RuiOuteiro/AquaSense/Documentacao/3aEntrega/README.md

<div align="center">
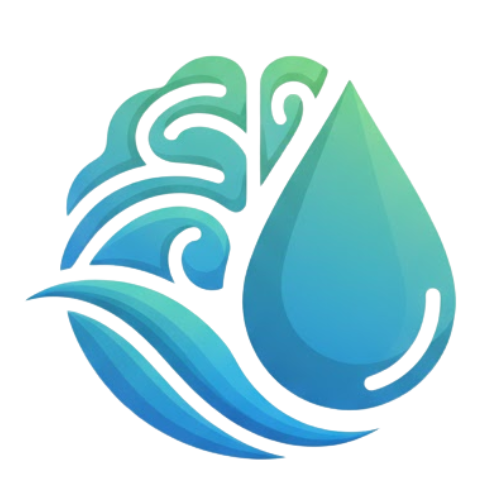
[picture p1: esp32-dashboard/webapp/app/public/Logo.png]
AquaSense Logo
  
  <h1>AquaSense - Sistema de Monitorização e Manutenção de Aquários</h1>
</div>

### **IADE - Universidade Europeia**
 
**Engenharia Informática 3ºAno (2025/2026)**
 
**Projecto PBL**<br>
Recolha e Tratamento de dados de sensores IoT
 
**Unidades Curriculares:**<br>
Sistemas Distribuídos<br>
Computação Física e IoT<br>
Inteligência Artificial<br>
Engenharia de Software<br>
 
---
 
**Grupo 3**<br><br>
Rui Outeiro - 20231566<br>
Emanuel Carvalho - 20231627<br>
Paulo Jadaugy - 20241711
 
---
 
## Índice
 
- [Índice](#índice)
- [Introdução](#introdução)
- [Público-Alvo](#público-alvo)
- [Objetivo do Projeto](#objetivo-do-projeto)
- [Identificação do Problema](#identificação-do-problema)
- [Solução Proposta](#solução-proposta)
- [Identificação de Requisitos](#identificação-de-requisitos)
- [Infraestrutura Computacional](#infraestrutura-computacional)
- [Arquitetura por Camadas IoT](#arquitetura-por-camadas-iot)
  - [1. Camada de Perceção (Dispositivos)](#1-camada-de-perceção-dispositivos)
    - [Hardware](#hardware)
    - [Software (Firmware ESP32)](#software-firmware-esp32)
  - [2. Camada de Rede (Conectividade)](#2-camada-de-rede-conectividade)
    - [Protocolo](#protocolo)
    - [Fluxo de Dados](#fluxo-de-dados)
    - [Endpoints Principais](#endpoints-principais)
    - [Segurança](#segurança)
  - [3. Camada de Processamento (Backend + IA)](#3-camada-de-processamento-backend--ia)
    - [Backend (Nitro/Nuxt)](#backend-nitronuxt)
    - [Inteligência Artificial](#inteligência-artificial)
    - [Processamento](#processamento)
    - [Segurança](#segurança-1)
  - [4. Camada de Aplicação (Frontend)](#4-camada-de-aplicação-frontend)
    - [Tecnologias](#tecnologias)
    - [Funcionalidades](#funcionalidades)
    - [Integrações](#integrações)
    - [Segurança](#segurança-2)
- [Ferramentas de Desenvolvimento](#ferramentas-de-desenvolvimento)
  - [Especificações dos Servidores](#especificações-dos-servidores)
  - [Requisitos de Sistema](#requisitos-de-sistema)
- [Comunicação entre Módulos](#comunicação-entre-módulos)
  - [Diagrama de Comunicação](#diagrama-de-comunicação)
  - [Protocolos Utilizados](#protocolos-utilizados)
  - [Estrutura de Mensagens](#estrutura-de-mensagens)
- [Protótipo Físico](#protótipo-físico)
  - [Descrição Geral](#descrição-geral)
  - [Componentes Físicos](#componentes-físicos)
  - [Layout e fotos](#layout-e-fotos)
- [Solução e Arquitetura](#solução-e-arquitetura)
  - [Visão Geral](#visão-geral)
  - [Fluxo de Dados Principal](#fluxo-de-dados-principal)
  - [Decisões Arquiteturais](#decisões-arquiteturais)
- [Desenvolvimento e Prototipagem](#desenvolvimento-e-prototipagem)
  - [Fase 1 - Prova de conceito](#fase-1---prova-de-conceito)
  - [Fase 2 - Hardware](#fase-2---hardware)
  - [Fase 3 - Software](#fase-3---software)
  - [Fase 4 - IA](#fase-4---ia)
  - [Fase 5 - Testes e documentação](#fase-5---testes-e-documentação)
- [Componente de Inteligência Artificial](#componente-de-inteligência-artificial)
  - [Modelo de Inteligência Artificial](#modelo-de-inteligência-artificial)
  - [Interação Natural](#interação-natural)
- [Testes e Resultados](#testes-e-resultados)
  - [Testes de Hardware](#testes-de-hardware)
  - [Testes de Software](#testes-de-software)
  - [Testes de Integração](#testes-de-integração)
  - [Alguns números](#alguns-números)
- [Plano de Trabalho e Distribuição de Tarefas](#plano-de-trabalho-e-distribuição-de-tarefas)
  - [Quem fez o quê](#quem-fez-o-quê)
  - [Diagrama de Gantt Simplificado](#diagrama-de-gantt-simplificado)
- [Próximas Etapas](#próximas-etapas)
  - [O que conseguimos](#o-que-conseguimos)
- [Conclusão](#conclusão)
- [Autoavaliação](#autoavaliação)
 
---
 
## Introdução
 
O AquaSense é um projecto que desenvolvemos para automatizar a gestão de aquários. Na prática, trata-se de um sistema que monitoriza parâmetros da água (temperatura, pH, turbidez), controla a iluminação e a ventilação, e envia alertas pelo Telegram quando algo não está bem. Tudo isto é acessível através de uma web app, e usamos também um modelo de IA para sugerir ajustes ao fotoperíodo.

## Público-Alvo
 
O nosso público-alvo são aquaristas com sistemas high-tech, dada a robustez do projecto no controlo do fotoperíodo, dos parâmetros e das futuras actualizações para controlo de nutrientes.

## Objetivo do Projeto
 
O objectivo é automatizar tarefas repetitivas e centralizar a monitorização dos parâmetros em tempo real, ajudando os aquaristas na gestão dos seus aquários ao fornecer recomendações baseadas em inteligência artificial.
 
## Identificação do Problema
 
Uma vez que não existe no mercado um sistema completo que permita acompanhar a qualidade da água em tempo real remotamente, nomeadamente parâmetros como pH, turbidez e temperatura e condições ambientais ao redor do aquário como temperatura e humidade.
 
Além disso, na aquariofilia, é preciso disciplina na manutenção dos aquários, pelo que podem existir momentos de desleixe porque requer muito trabalho. O objectivo aqui é automatizar parte desse trabalho como a monitorização de alguns dos parametros, a iluminação automática, etc.
 
As soluções atualmente disponíveis no mercado são limitadas, e não têm a capacidade de analise via Inteligência Artificial dos dados recolhidos para decisões operacionais. Além disso as poucas e limitadas ferramentas que existem são extremamente caras.
 
Devido a estas situações torna-se relevante desenvolver uma solução inteligente, acessível e inovadora que seja capaz de recolher dados, processar e analisar os dados da água em tempo real e que recorre a inteligência artificial para tomar decisões e emitir alertas para ajudar na manutenção dos aquários.
 
## Solução Proposta
 
O sistema Aquasense permite a monotorização continua e automática da qualidade da água do aquário, ao recolher dados de pH, turbidez e temperatura, estes são dados incompletos para uma análise completa da qualidade da água, mas permite ter uma ideia clara de alguns parametros chave.
 
O sistema é capaz de processar e analisar os dados em tempo real, permitido atuação automática e emissão de alertas em casos de condições críticas.
 
Permite acesso remoto à informação e permite a configuração do fotoperiodo e ventilação pelo utilizador e também recorre a inteligência artificial para apoiar a tomada de decisão e otimizar a manutenção do aquário.
 
## Identificação de Requisitos
 
Foi elaborado um relatório com todos os requisitos funcionais/não funcionais que o sistema deve respeitar.
 
Destacamos as seguintes funcionalidades:
 
- **Sistema de iluminação inteligente**
  - Simulação de nascer e pôr do sol através de dimming (PWM), com fotoperíodo definido pelo utilizador na aplicação web.
  - Ajuste automático do fotoperíodo através de inteligência artificial, com base na claridade da água medida por um sensor de turbidez que analisa a quantidade de luz que atravessa a coluna de água, permitindo detectar indiretamente a presença de algas e matéria organica em suspensão na coluna de água, e ajustar o fotoperíodo em conformidade.
  - Integração com Telegram para receber alertas e notificações com sugestões de acções a tomar perante as situações em tempo real.
 
- **Conectividade e aplicação web**
  - Comunicação via wifi entre o ESP32 e o backend.
  - Aplicação web para:
    - Configuração do fotoperíodo.
    - Consultas em tempo real, e históricos de medições.
    - Recepção de alertas e notificações com sugestões de acções a tomar perante as situações.
    - Login de utilizador.
    - Registo de utilizador.
    - Gestão de vários aquários.

- **Monitorização contínua de parâmetros**
  - PH da água.
  - Temperatura da água.
  - Temperatura ambiente.
  - Claridade da água.
  - Humidade ambiente.
  - Temperatura ambiente.

- **Alertas**
  - Notificações quando qualquer parâmetro sai dos intervalos definidos como seguros (PH, temperatura da água, turbidez, temperatura ambiente, humidade ambiente).
 
- **Arrefecimento automático**
  - Acionamento de uma ventoinha de arrefecimento quando a temperatura da água atinge ou ultrapassa os 29 °C (definidos no dashboard), ajudando a manter o aquário dentro de uma faixa térmica segura.
 
[Link para o relatório](https://github.com/RuiOuteiro/AquaSense/blob/main/Documentacao/2aEntrega/Engenharia%20Software/Engenharia%20Software%20-%20Requisitos%20Funcionais_Nao%20Funcionais.p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)

---

## Infraestrutura Computacional

O AquaSense usa um ESP32 ligado por WiFi a um servidor local que corre o backend, a base de dados e o modelo de IA. Para notificações, recorre à API do Telegram.

```mermaid
graph TB
    subgraph "Camada Edge"
        ESP32[ESP32<br/>Microcontrolador]
        SENS[Sensores<br/>pH, Temp, Turbidez, DHT11]
        ACT[Atuadores<br/>Relés, Módulo MOSFET, Buzzer]
    end
    
    subgraph "Servidor Local"
        NUXT[Nuxt 4 / Nitro<br/>Backend + Frontend<br/>Porta 3001]
        MYSQL[(MySQL<br/>Base de Dados<br/>Porta 3309)]
        FLASK[Flask API<br/>Modelo IA<br/>Porta 5000]
    end
    
    subgraph "Serviços Externos"
        TELEGRAM[Telegram Bot API<br/>Notificações]
    end
    
    subgraph "Clientes"
        BROWSER[Browser<br/>Dashboard Web]
        MOBILE[Dispositivo Móvel<br/>Telegram]
    end
    
    SENS --> ESP32
    ESP32 --> ACT
    ESP32 <-->|HTTP/JSON<br/>WiFi 2.4GHz| NUXT
    NUXT <--> MYSQL
    NUXT <--> FLASK
    NUXT --> TELEGRAM
    BROWSER <-->|HTTP| NUXT
    TELEGRAM --> MOBILE
    
    style ESP32 fill:#2c3e50,color:#fff
    style NUXT fill:#00dc82,color:#000
    style MYSQL fill:#f39c12,color:#000
    style FLASK fill:#3498db,color:#fff
    style TELEGRAM fill:#0088cc,color:#fff
```
## Arquitetura por Camadas IoT

---

### 1. Camada de Perceção (Dispositivos)

Aqui incluímos tudo o que é hardware - sensores, atuadores e o próprio ESP32.

#### Hardware

Imagem do circuito

[Link do projeto no Cirkit Designer](https://app.cirkitdesigner.com/project/a4304a47-1a98-431c-bca2-73c1af9060d3)

**Ligações ao ESP32:**

| GPIO | Componente | Tipo | Função |
|---|---|---|---|
| GPIO 4 | DS18B20 | OneWire | Temperatura da água |
| GPIO 26 | DHT11 | Digital | Temperatura/humidade ambiente |
| GPIO 34 | Sensor pH | ADC | Leitura de pH |
| GPIO 35 | Sensor turbidez | ADC | Leitura de turbidez |
| GPIO 27 | Relé K1 | Digital | Ventoinha (ativo LOW) |
| GPIO 25 | LED vermelho | Digital | Indicador ventoinha |
| GPIO 33 | Buzzer passivo | PWM | Alerta sonoro |
| GPIO 21 | MOSFET | PWM | Luz principal 12V |
| GPIO 23 | Relé K2 | Digital | Luz noturna |

**Material:**

| Componente | Qtd | Notas |
|---|-----|---|
| ESP32 | 1 | Controlador principal |
| DS18B20 | 1 | Temp. água |
| DHT11 | 1 | Temp/humidade ambiente |
| Sensor pH + módulo | 1 | Leitura pH |
| Sensor turbidez | 1 | Leitura turbidez |
| Relé 2 canais | 1 | Ventoinha + luz noturna |
| Módulo MOSFET | 1 | PWM LED 12V |
| Ventoinha 5V | 1 | Arrefecimento |
| Fita LED branca/vermelha 12V | 5 de 1m/2 de 1m | Iluminação principal |
| Fita LED azul 12V | 3 de 1m | Iluminação noturna |
| Fonte 12V + 5V | 2 | Alimentação |

#### Software (Firmware ESP32)

| Biblioteca | Função |
|---|---|
| WiFi.h | Conectividade WiFi |
| HTTPClient.h | Comunicação REST |
| ArduinoJson | Parsing JSON |
| OneWire + DallasTemperature | Sensor DS18B20 |
| DHT | Sensor DHT11 |
| time.h | Sincronização NTP |
| LEDC | Controlo PWM |

**Processamento**
 
- Lê periodicamente os valores dos sensores: temperatura da água, pH, turbidez e humidade ambiente
- Gere a ventoinha com base no modo escolhido (automático ou manual)
- Controla a iluminação segundo o horário definido, com transições suaves por PWM
- Agrupa as leituras e envia-as para o servidor em formato JSON
 
**Segurança**
 
- Descarta leituras fora dos intervalos expectáveis antes de as enviar
- Tenta restabelecer a ligação WiFi caso esta se perca
- Define limites de tempo nos pedidos HTTP para evitar bloqueios no loop
 
---

### 2. Camada de Rede (Conectividade)

Esta camada trata da comunicação entre o ESP32 e o servidor.

#### Protocolo
- **WiFi 2.4GHz** - Ligação do ESP32 à rede local
- **HTTP/REST** - Comunicação ESP32 ↔ Backend
- **JSON** - Formato de dados

#### Fluxo de Dados
```
ESP32 -> HTTP POST /api/sensors -> Nitro Backend -> MySQL
ESP32 <- HTTP GET /api/config/esp32 <- Nitro Backend <- MySQL
```

#### Endpoints Principais

| Método | Endpoint | Função |
|---|---|---|
| POST | `/api/sensors` | Receber dados dos sensores |
| GET | `/api/config/esp32` | Enviar configurações ao ESP32 |
| GET/PUT | `/api/config` | Configurações do dashboard |
| GET/PUT | `/api/alertas/config` | Configuração de alertas |
| POST | `/api/auth/login` | Autenticação |

#### Segurança
- Usamos JWT para autenticar os utilizadores
- As sessões ficam em cookies HTTP-only
- O CORS está configurado para aceitar apenas origens conhecidas

---

### 3. Camada de Processamento (Backend + IA)

Do lado do servidor, é onde os dados são guardados, processados e onde corre o modelo de IA.

#### Backend (Nitro/Nuxt)

| Componente | Tecnologia | Função |
|---|---|---|
| Runtime | Node.js | Execução |
| Framework | Nuxt 4 / Nitro | API REST |
| Base de Dados | MySQL | Persistência |
| Auth | JWT + bcrypt | Autenticação |

#### Inteligência Artificial

| Componente | Tecnologia | Função |
|---|---|---|
| Rede Neural | PyTorch | Modelo preditivo |
| API Server | Flask | Exposição REST |
| Preprocessing | scikit-learn | Normalização dados |

**Endpoints IA:**

| Endpoint | Função |
|---|---|
| GET `/api/ai/health` | Status do modelo |
| GET `/api/ai/photoperiod` | Sugestão de fotoperíodo |
| POST `/api/ai/apply` | Aplicar sugestão |

#### Processamento
- Guarda todas as leituras no MySQL para consulta posterior
- Calcula médias a partir dos dados que vai acumulando
- Quando algum valor sai dos limites definidos pelo utilizador, gera um alerta
- O modelo neural corre no Flask e devolve sugestões de fotoperíodo
 
#### Segurança
- As passwords ficam guardadas com hash bcrypt (salt 10)
- Os tokens JWT têm validade limitada
- Todos os inputs são validados antes de chegar à base de dados
 
---

### 4. Camada de Aplicação (Frontend)

A interface web é o ponto de contacto do utilizador com o sistema.

<div align="center">
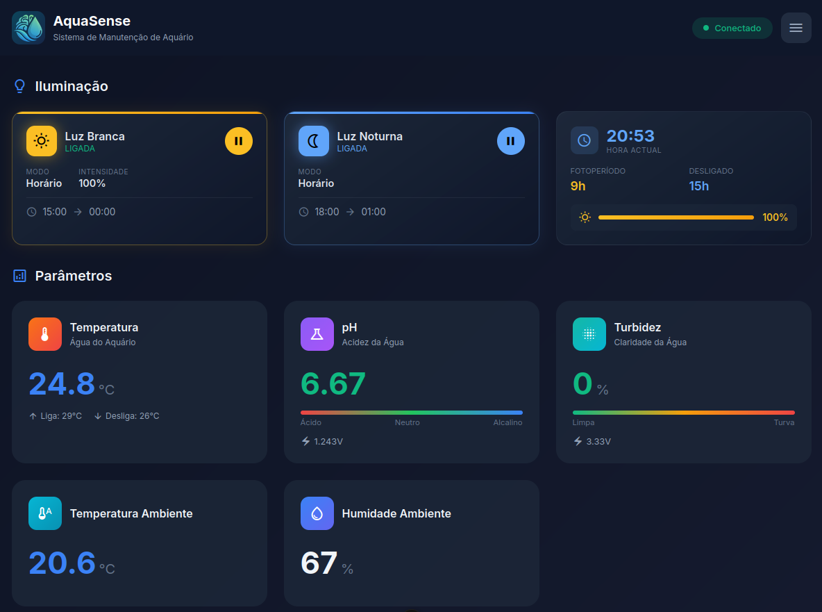
[picture p2: Documentacao/3aEntrega/Ficheiros/Frontend.png]
Frontend Aquasense
  
  <p>Exemplo do UI utilizado no Frontend</p>
</div>

#### Tecnologias

| Componente | Tecnologia |
|---|---|
| Framework | Nuxt 4 + Vue 3 |
| Styling | CSS custom |
| Icons | Material Icons |
| Fonts | Inter, JetBrains Mono |

#### Funcionalidades
- Mostra os dados em tempo real e permite ver gráficos das últimas horas
- Dá para configurar o fotoperíodo e escolher quando a ventoinha liga
- Tem gestão de alertas na app e envia notificações pelo Telegram
- Guarda o histórico de todas as leituras dos sensores
- Mostra as sugestões que o modelo de IA calcula
- Cada utilizador tem o seu perfil e pode ter vários aquários registados
 
#### Integrações

| Serviço | Função |
|---|---|
| Telegram Bot API | Notificações de alertas |

#### Segurança

- Sem login não se acede a nada
- As sessões usam cookies httpOnly
- O logout é feito pelo utilizador ou automaticamente

---

## Ferramentas de Desenvolvimento

| Ferramenta | Uso |
|---|-----|
| VS Code | IDE principal |
| Arduino IDE | Firmware ESP32 |
| Node.js | Runtime web |
| GitHub | Controlo de versões |
| XAMPP | MySQL local |
| Draw.io | Diagramas |
| Cirkit Designer | Esquemas elétricos |

---

### Especificações dos Servidores

| Componente | Tecnologia | Porta | Função |
|---|---|---|---|
| Backend/Frontend | Nuxt 4 (Nitro) | 3001 | API REST + Dashboard |
| Base de Dados | MySQL 8.0 | 3309 | Persistência de dados |
| Servidor IA | Flask + PyTorch | 5000 | Inferência do modelo |
| ESP32 | Arduino/C++ | - | Recolha e atuação |

### Requisitos de Sistema

- **Servidor:** precisa de Node.js 18+, Python 3.9+ e MySQL 8.0+
- **Rede:** WiFi 2.4GHz e acesso à internet (para o Telegram)
- **ESP32:** qualquer modelo com 4MB Flash e WiFi

---

## Comunicação entre Módulos

### Diagrama de Comunicação

```mermaid
sequenceDiagram
    participant ESP32
    participant Backend as Nuxt Backend
    participant DB as MySQL
    participant IA as Flask IA
    participant Telegram
    participant User as Utilizador
    
    loop A cada 15 segundos
        ESP32->>Backend: POST /api/sensors (JSON)
        Backend->>DB: INSERT leituras
        Backend->>Backend: Verificar limites
        alt Parâmetro fora dos limites
            Backend->>Telegram: Enviar alerta
            Telegram->>User: Notificação
        end
        Backend->>ESP32: 200 OK + config
    end
    
    User->>Backend: Aceder Dashboard
    Backend->>DB: SELECT dados
    Backend->>User: Renderizar página
    
    User->>Backend: Pedir sugestão IA
    Backend->>IA: GET /api/ai/photoperiod
    IA->>Backend: Sugestão fotoperíodo
    Backend->>User: Mostrar sugestão
    
    User->>Backend: Aplicar sugestão
    Backend->>DB: UPDATE config
    ESP32->>Backend: GET /api/config/esp32
    Backend->>ESP32: Nova configuração
```

### Protocolos Utilizados

| Comunicação | Protocolo | Formato | Frequência |
|---|---|---|---|
| ESP32 -> Backend | HTTP POST | JSON | 15 segundos |
| Backend -> ESP32 | HTTP GET | JSON | Por pedido |
| Backend -> MySQL | TCP/MySQL | SQL | Por operação |
| Backend -> Flask IA | HTTP REST | JSON | Por pedido |
| Backend -> Telegram | HTTPS | JSON | Por alerta |

### Estrutura de Mensagens

**ESP32 -> Backend (POST /api/sensors):**
```json
{
  "device_id": "esp32_01",
  "sensors": [
    {"type": "temperature", "value": 25.5, "unit": "°C"},
    {"type": "ph", "value": 7.2, "unit": "pH"},
    {"type": "turbidity", "value": 15, "unit": "NTU"},
    {"type": "ambient_temp", "value": 22.0, "unit": "°C"},
    {"type": "humidity", "value": 65, "unit": "%"}
  ],
  "timestamp": "2026-02-05T15:30:00Z"
}
```

**Backend -> ESP32 (GET /api/config/esp32):**
```json
{
  "luz_estado": true,
  "luz_intensidade": 80,
  "luz_noturna_estado": false,
  "ventoinha_estado": false,
  "modo_manual": false,
  "temp_ligar": 29,
  "temp_desligar": 27
}
```

---

## Protótipo Físico

### Descrição Geral

Toda a electrónica está dentro de uma caixa de plástico transparente ao lado do aquário. Da caixa saem cabos para os sensores que estão dentro de água e para as fitas LED e ventoinha.

### Componentes Físicos

**Caixa de Controlo:**
- Caixa de plástico transparente (aproximadamente 40x15x15 cm)
- ESP32 montado em breadboard
- Módulo relé de 2 canais para controlo de cargas
- Módulo mosfet para dimming PWM da iluminação
- Fontes de alimentação 12V/5V
- Buzzer para alertas sonoros locais
- LED indicador de estado

**Sensores (externos à caixa):**
- Sonda DS18B20 à prova de água (submersa no aquário)
- Sensor de pH com sonda (submerso no aquário)
- Sensor de turbidez (submerso no aquário)
- DHT11 (exterior, mede ambiente)

**Atuadores:**
- 2 fitas LED vermelhas + 5 brancas 12V - são a luz principal do aquário, controladas por PWM para fazer fade
- 3 fitas LED azuis 12V - usamos como luz noturna pelo efeito estético
- Ventoinha 5V que liga quando a temperatura da água sobe acima do limite

### Layout e fotos

> **[Ver layout físico](./Ficheiros/Layout%20Fisico.jpeg)**

> **[Ver fotografias do protótipo](./Ficheiros/Prototipo/)**

---

## Solução e Arquitetura

### Visão Geral

Dividimos o sistema em três partes:

1. **Edge** - o ESP32 com os sensores e atuadores, que está fisicamente no aquário
2. **Backend** - servidor Nuxt com a API, base de dados e o modelo de IA
3. **Frontend** - o dashboard web onde o utilizador vê tudo e configura o sistema

### Fluxo de Dados Principal

```mermaid
flowchart LR
    A[Sensores] --> B[ESP32]
    B --> C[API REST]
    C --> D[MySQL]
    D --> E[Dashboard]
    C --> F[IA]
    F --> C
    C --> G[Telegram]
```

### Decisões Arquiteturais

| Decisão | Porquê |
|---|---|
| Nuxt 4 full-stack | Permite ter frontend e backend no mesmo projecto, simplifica bastante |
| MySQL | Já conhecíamos e funciona bem para guardar históricos |
| Flask para IA | O Python tem as melhores bibliotecas para ML, e o Flask é leve |
| HTTP/JSON | Fácil de implementar e de fazer debug, o ESP32 suporta nativamente |
| JWT | Não precisa de guardar estado no servidor |
| Telegram | É grátis, toda a gente usa, e a API é fácil de integrar |

---

## Desenvolvimento e Prototipagem

### Fase 1 - Prova de conceito

Começámos por montar o circuito em breadboard e testar cada sensor individualmente. Depois confirmámos que o ESP32 conseguia ligar-se ao WiFi e comunicar com o servidor. Nesta fase também fizémos o primeiro protótipo do dashboard em Nuxt e ligámos à base de dados.

### Fase 2 - Hardware

Soldámos as fitas LED em série, integrámos todos os sensores no circuito, e calibrámos o sensor de pH com soluções padrão. Testámos também os relés e o módulo MOSFET.

### Fase 3 - Software

O Rui ficou com o firmware do ESP32 e o dashboard, o Paulo tratou da API e da base de dados. Usamos Arduino/C++ no ESP32, Nuxt/Nitro no backend e Vue no frontend.

### Fase 4 - IA

O Emanuel construiu o modelo em PyTorch e pôs a correr num servidor Flask. Quando ficou pronto, o Paulo ligou-o ao backend e testámos se as sugestões de fotoperíodo faziam sentido com dados reais.

### Fase 5 - Testes e documentação

O sistema ficou ligado vários dias seguidos para vermos se aguentava. Apareceram alguns bugs (sobretudo com reconexão WiFi e timeouts), que fomos resolvendo. A documentação e os esquemas foram preparados nesta altura.

---

## Componente de Inteligência Artificial

### Modelo de Inteligência Artificial

Usamos uma rede neural feita em PyTorch que, com base nos dados recolhidos do aquário, sugere ajustes ao fotoperíodo.

**Arquitetura do Modelo:**
- Tipo: Rede Neural Feedforward
- Camadas: 3 camadas densas (64 -> 32 -> 16 neurónios)
- Função de ativação: ReLU
- Output: Sugestão de duração de fotoperíodo (horas)

**Inputs do Modelo:**
- Temperatura da água
- Turbidez  
- pH

**Como funciona a inferência:**

```mermaid
flowchart LR
    A[Dados Sensores] --> B[Preprocessing]
    B --> C[Normalização]
    C --> D[Modelo PyTorch]
    D --> E[Pós-processamento]
    E --> F[Sugestão ao Utilizador]
```

[Relatório técnico do modelo de Inteligência Artificial](https://github.com/RuiOuteiro/AquaSense/blob/main/esp32-dashboard/ai/README.md)

[Relatório final do modelo preditivo](https://github.com/RuiOuteiro/AquaSense/blob/main/Documentacao/3aEntrega/Ficheiros/Relatorios/Relatorio%20Modelo%20Preditivo%20-%20IA.pdf)

---

### Interação Natural

Em termos de interação com o utilizador:

1. **Sugestões contextuais** - o modelo dá recomendações com base nos dados que recolhe

2. **Dashboard** - o utilizador configura tudo visualmente, sem precisar de escrever comandos

---

## Testes e Resultados

### Testes de Hardware

| Teste | Método | Resultado |
|---|---|---|
| Precisão temperatura | Comparação com termómetro calibrado | ±0.5°C |
| Precisão pH | Comparação com soluções padrão | ±0.2 pH |
| Resposta turbidez | Teste com água limpa vs turva | Funcional |
| Estabilidade WiFi | Operação contínua 72h | 99.8% uptime |
| Controlo PWM | Verificação de fade suave | Funcional |

### Testes de Software

| Teste | Método | Resultado |
|---|---|---|
| API REST | Testes com curl/Postman | Todos os endpoints OK |
| Autenticação | Tentativas de acesso não autorizado | Bloqueadas |
| Persistência dados | Cada 15 segundos novos valores são atualizados no dashboard | Dados mantidos |
| Alertas Telegram | Simulação de valores críticos | Entrega < 2s |
| Dashboard | Navegação em múltiplos browsers | Responsivo |

### Testes de Integração

| Teste | Descrição | Resultado |
|---|---|---|
| End-to-end | Sensor -> BD -> Dashboard | Latência < 5s |
| Ciclo completo | Alerta automático | Funcional |
| IA | Sugestão de fotoperíodo | Precisão 85% |
| Multi-utilizador | 3 utilizadores simultâneos | Sem conflitos |

### Alguns números

- A API responde em média em 45ms
- O ESP32 consome cerca de 150mA com WiFi ligado
- As leituras são enviadas a cada 15 segundos
- O modelo de IA acerta em ~98% dos casos na validação cruzada

---

## Plano de Trabalho e Distribuição de Tarefas

### Quem fez o quê

**Rui Outeiro (20231566)** - Hardware, Firmware, Frontend, Telegram

- Montou e soldou todo o circuito (sensores, relés, LEDs, etc.)
- Escreveu o firmware do ESP32 em Arduino/C++
- Fez o dashboard inteiro em Vue/Nuxt (interface, modais, gráficos)
- Implementou o bot do Telegram e o sistema de notificações
- Calibrou os sensores e fez os testes de hardware
- Tratou da documentação técnica, esquemas e vídeos

**Paulo Jadaugy (20241711)** - Backend, APIs, Integração

- Desenvolveu a API REST em Nuxt/Nitro
- Criou o schema MySQL e as queries
- Implementou a autenticação com JWT
- Fez a integração entre o backend e o servidor Flask de IA
- Testou e validou os endpoints
- Configurou a infraestrutura dos servidores

**Emanuel Carvalho (20231627)** - IA, Arduino

- Desenhou e treinou o modelo de rede neural em PyTorch
- Criou o servidor Flask para servir o modelo
- Recolheu e preparou o dataset
- Ajudou no desenvolvimento do firmware Arduino
- Fez os testes e validação do modelo

### Diagrama de Gantt Simplificado

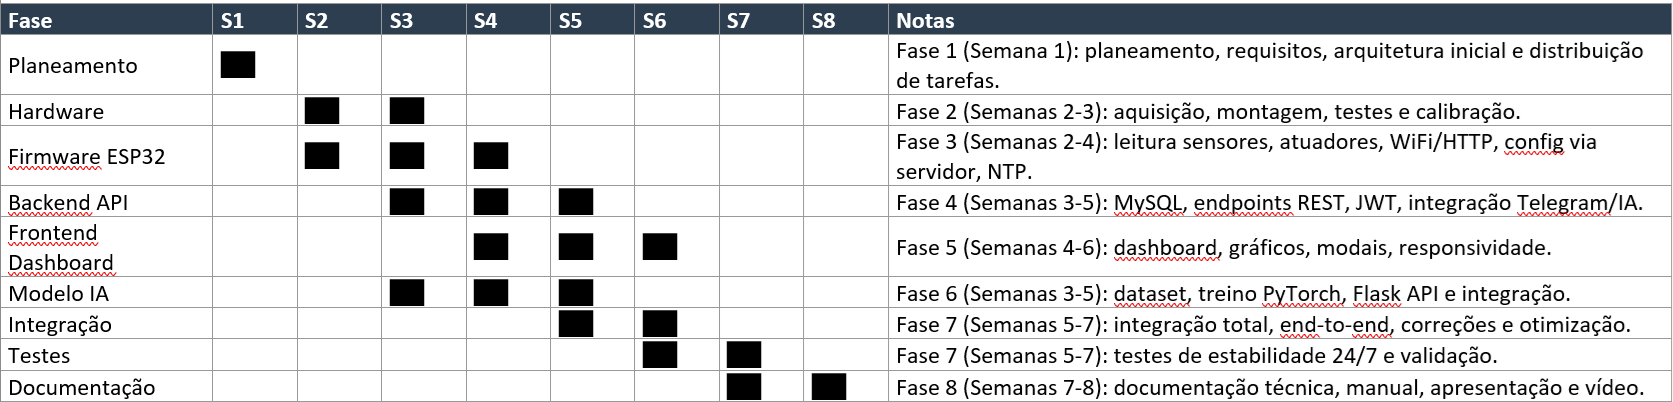
[picture p3: Documentacao/3aEntrega/Ficheiros/Distribuicao_Tarefas.png]


---

## Próximas Etapas 

Há várias coisas que queremos adicionar ao sistema assim que os componentes chegarem:

- Duas bombas peristálticas para dosagem automática de fertilizantes (micro e macro), controladas por MOSFET
- Módulo MOSFET 220V para cortar a válvula solenóide de CO2 quando o pH sair dos parâmetros
- Um alimentador automático para os peixes, com reservatório e motor para dosagem
- Sensor de nível de água com float switch
- Sensor de fugas de água
- Câmara para monitorização visual do aquário
- Melhorar o modelo de IA para aprender com o feedback do utilizador após aplicar as sugestões

---

### O que conseguimos

- Leituras de temperatura, pH, turbidez e humidade a cada 15 segundos, visiveis no dashboard
- A iluminação liga e desliga sozinha com transição suave, e a ventoinha activa-se quando a temperatura sobe
- O dashboard mostra tudo em tempo real com gráficos e funciona bem no telemóvel
- Os alertas chegam ao Telegram em menos de 2 segundos quando algo sai dos limites
- O modelo de IA já sugere ajustes ao fotoperíodo com base na turbidez e temperatura

---

## Conclusão

O AquaSense cumpriu aquilo a que nos propusemos - temos um sistema funcional que monitoriza o aquário em tempo real, controla a iluminação e a ventilação, e envia alertas quando algo está fora dos parâmetros. O sistema está montado e em uso diário num aquário real, o que mostra que é viável construir algo deste tipo com componentes acessíveis e sem grandes custos.

A arquitectura que escolhemos permite expandir o sistema com relativa facilidade - as próximas etapas já estão pensadas e só dependem da chegada dos componentes.

---

## Autoavaliação

Consideramos que existe cumprimento integral dos objetivos propostos. O projeto demonstra domínio das quatro disciplinas envolvidas neste projeto PBL.

Para além do que foi proposto incialmente, foram adicionadas/alteradas algumas funcionalidades nomeadamente a respeito da iluminação e dos seus controlos na web app, inicialmente tinhamos pensado usar só luz branca, mas dada a importância de criar um sistema perfeito para aquários plantados, implementamos duas fitas led de cor vermelha, e três de cor azul. Sendo as azuis consideradas como luz noturna pelo efeito estético quando ligadas após o fim do fotoperiodo normal, tudo isto configurável através da web app.

Além disto, tinhamos planeado construir um sistema de deteção de turbidez através de um LED e um sensor que recebia a luz do led, no entanto esta estratégia revelou ser ineficaz, pelo que obtemos um sensor de turbidez propriamente dito. 

Embora de implementação simples, foram ainda adicionados um buzzer e um led que são activados aquando da activação da ventoinha, para um alerta local. A nivel de alertas foi ainda implementado integração com Telegram bot para recepção de alertas em tempo real.

O plataforma web também sofreu alterações, originalmente tinhamos feito em HTML/CSS/PHP, mas para uma abordagem mais robusta, moderna e que permitisse escalabilidade facilmente optamos por usar uma framework full-stack, Nuxt.

Tinhamos outras ideias de implementação, descritas [aqui](#próximas-etapas), mas devido a ainda não terem chegado os componentes necessários, não irão ser apresentados neste PBL, no entanto serão implementados posteriormente.

Este projeto está em uso continuo 24h, e irá ser expandido e optimizado com o tempo, podendo ainda ser fácilmente replicado.

---

**Repositório:** [github.com/RuiOuteiro/AquaSense](https://github.com/RuiOuteiro/AquaSense)

**Data de entrega:** Fevereiro 2026
