RuiOuteiro/AquaSense/Documentacao/3aEntrega/Ficheiros/Layout Fisico.jpeg

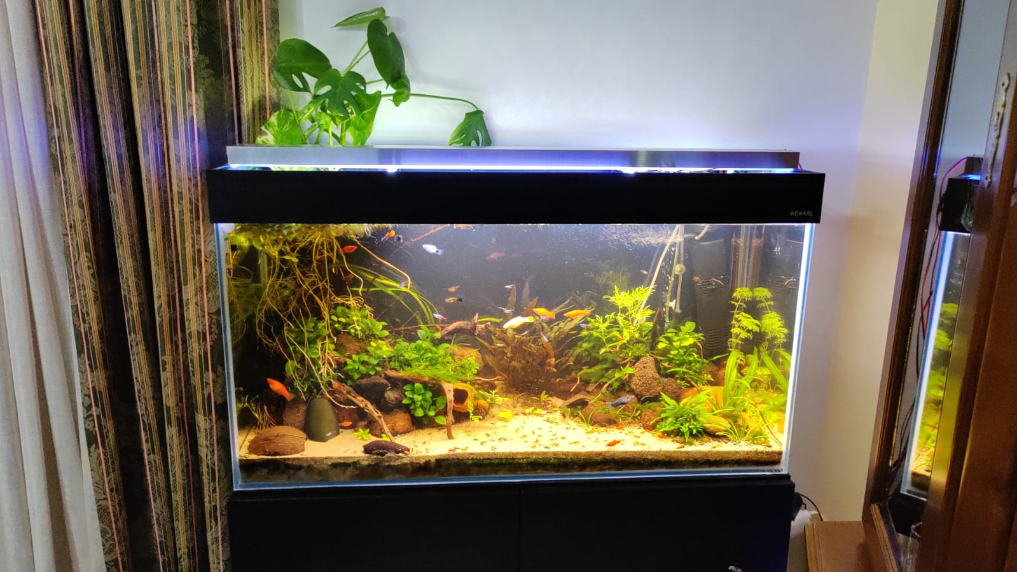
Documentacao/3aEntrega/Ficheiros/Layout Fisico.jpeg
