RuiOuteiro/AquaSense/Documentacao/3aEntrega/Ficheiros/Prototipo/imagem_001.jpeg

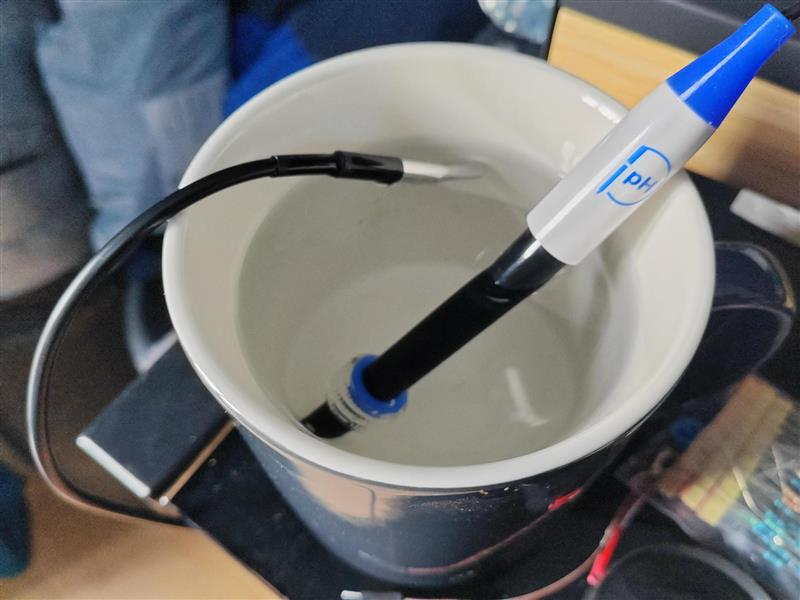
Documentacao/3aEntrega/Ficheiros/Prototipo/imagem_001.jpeg
