RuiOuteiro/AquaSense/Documentacao/3aEntrega/Ficheiros/Prototipo/imagem_002.jpeg

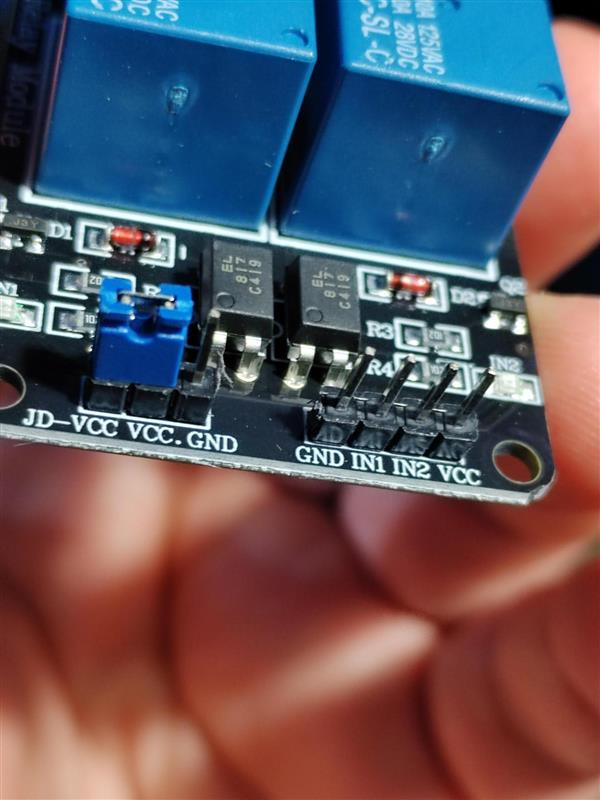
Documentacao/3aEntrega/Ficheiros/Prototipo/imagem_002.jpeg
