RuiOuteiro/AquaSense/Documentacao/3aEntrega/Ficheiros/Prototipo/imagem_003.jpeg

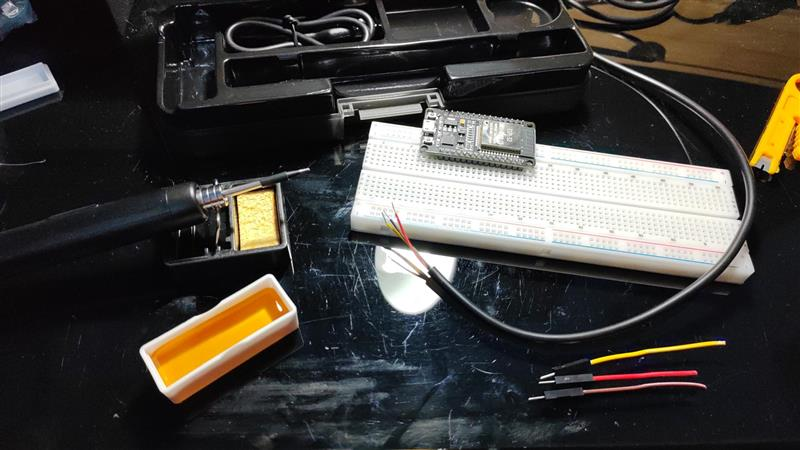
Documentacao/3aEntrega/Ficheiros/Prototipo/imagem_003.jpeg
