RuiOuteiro/AquaSense/Documentacao/3aEntrega/Ficheiros/Prototipo/imagem_004.jpeg

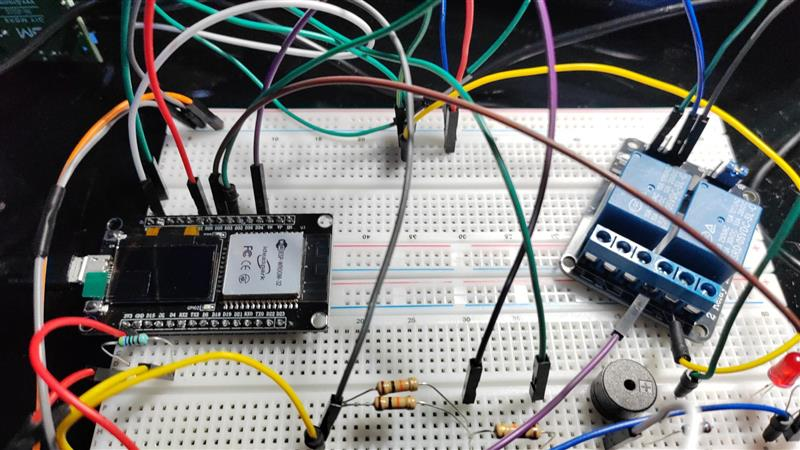
Documentacao/3aEntrega/Ficheiros/Prototipo/imagem_004.jpeg
