RuiOuteiro/AquaSense/Documentacao/3aEntrega/Ficheiros/Prototipo/imagem_005.jpeg

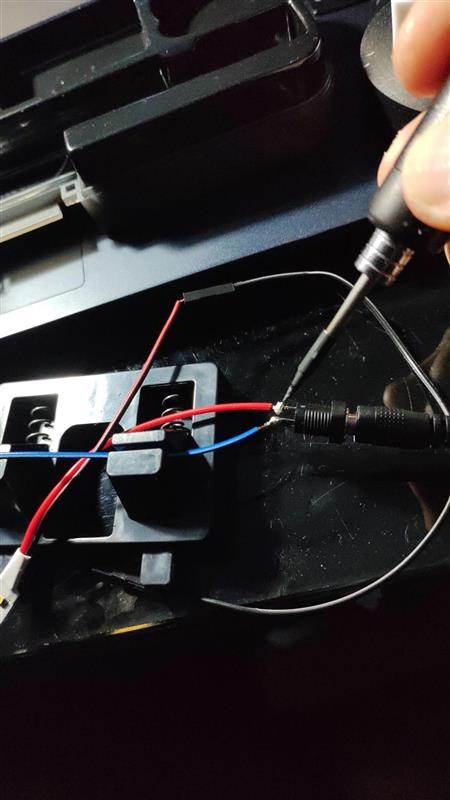
Documentacao/3aEntrega/Ficheiros/Prototipo/imagem_005.jpeg
