RuiOuteiro/AquaSense/Documentacao/3aEntrega/Ficheiros/Prototipo/imagem_006.jpeg

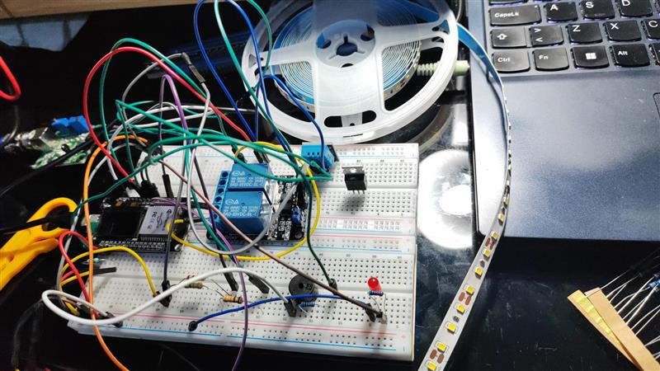
Documentacao/3aEntrega/Ficheiros/Prototipo/imagem_006.jpeg
