RuiOuteiro/AquaSense/Documentacao/3aEntrega/Ficheiros/Prototipo/imagem_007.jpeg

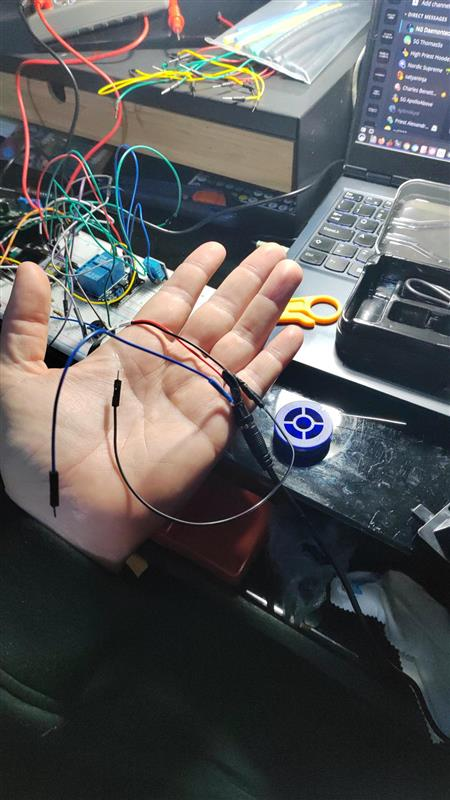
Documentacao/3aEntrega/Ficheiros/Prototipo/imagem_007.jpeg
