RuiOuteiro/AquaSense/Documentacao/3aEntrega/Ficheiros/Prototipo/imagem_008.jpeg

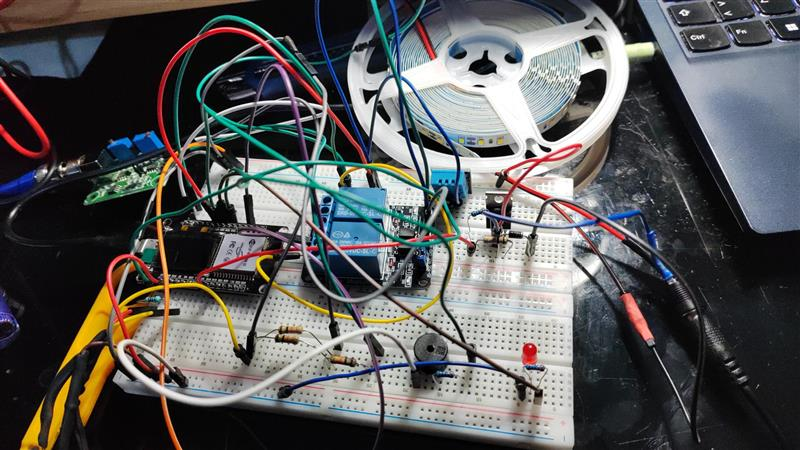
Documentacao/3aEntrega/Ficheiros/Prototipo/imagem_008.jpeg
