RuiOuteiro/AquaSense/Documentacao/3aEntrega/Ficheiros/Prototipo/imagem_009.jpeg

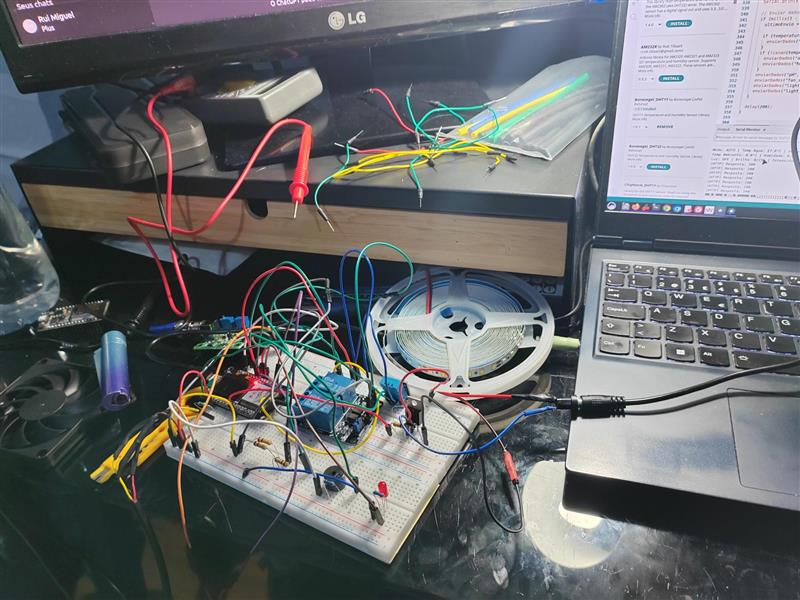
Documentacao/3aEntrega/Ficheiros/Prototipo/imagem_009.jpeg
