RuiOuteiro/AquaSense/Documentacao/3aEntrega/Ficheiros/Prototipo/imagem_010.jpeg

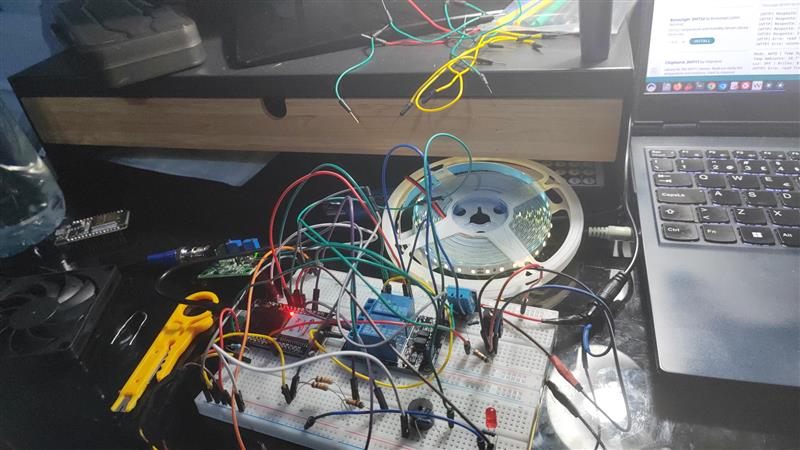
Documentacao/3aEntrega/Ficheiros/Prototipo/imagem_010.jpeg
