RuiOuteiro/AquaSense/Documentacao/3aEntrega/Ficheiros/Prototipo/imagem_011.jpeg

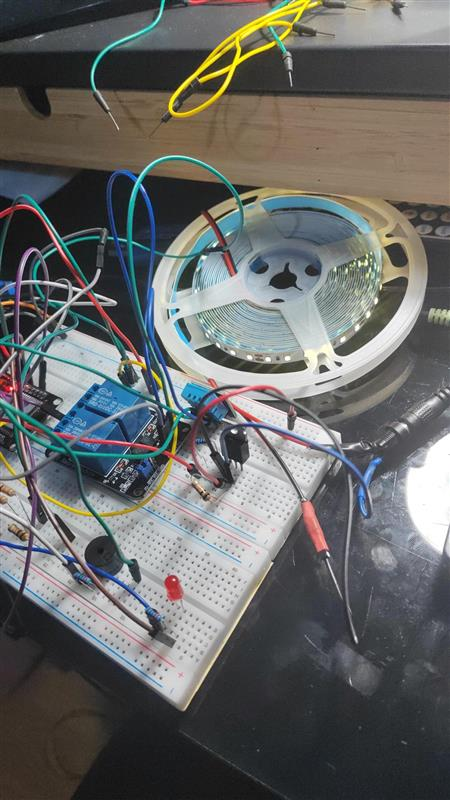
Documentacao/3aEntrega/Ficheiros/Prototipo/imagem_011.jpeg
