RuiOuteiro/AquaSense/Documentacao/3aEntrega/Ficheiros/Prototipo/imagem_012.jpeg

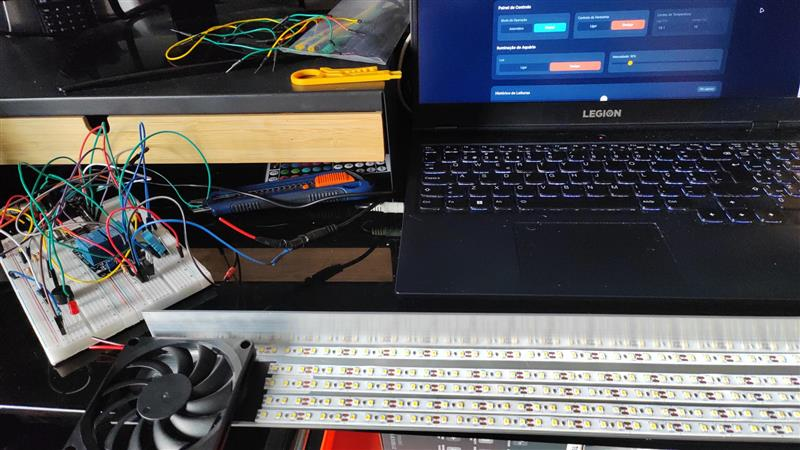
Documentacao/3aEntrega/Ficheiros/Prototipo/imagem_012.jpeg
