RuiOuteiro/AquaSense/Documentacao/3aEntrega/Ficheiros/Prototipo/imagem_013.jpeg

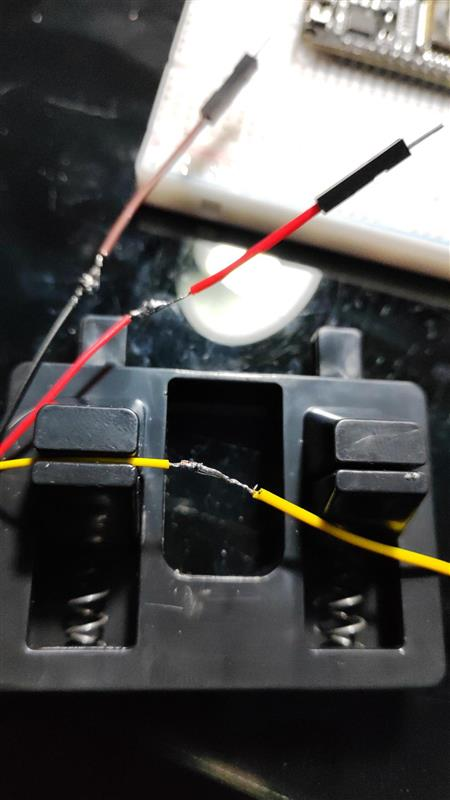
Documentacao/3aEntrega/Ficheiros/Prototipo/imagem_013.jpeg
