RuiOuteiro/AquaSense/Documentacao/3aEntrega/Ficheiros/Prototipo/imagem_014.jpeg

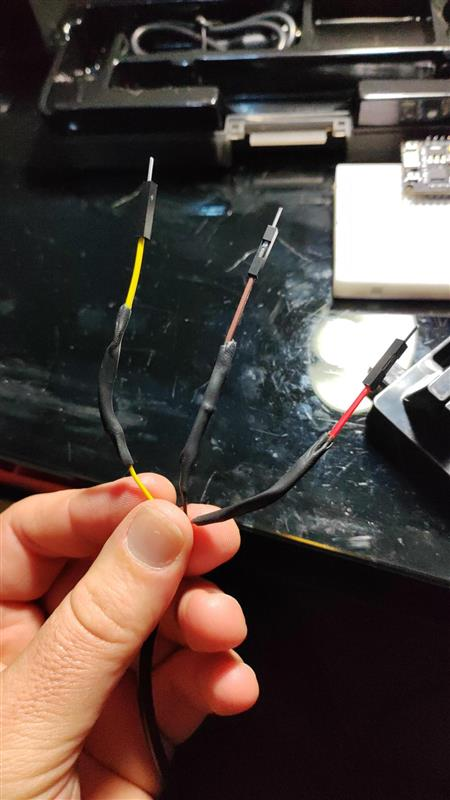
Documentacao/3aEntrega/Ficheiros/Prototipo/imagem_014.jpeg
