RuiOuteiro/AquaSense/Documentacao/3aEntrega/Ficheiros/Prototipo/imagem_015.jpeg

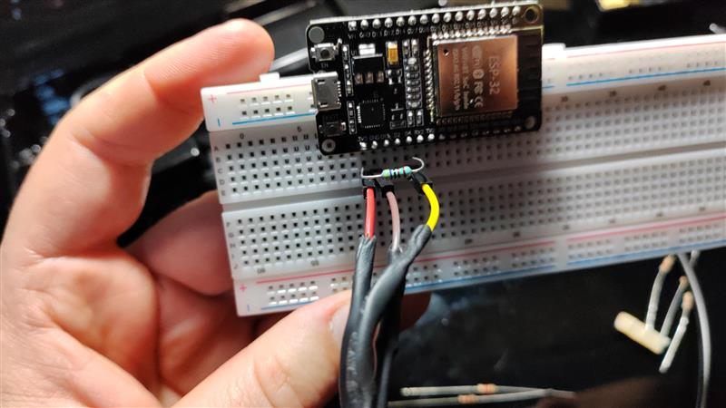
Documentacao/3aEntrega/Ficheiros/Prototipo/imagem_015.jpeg
