RuiOuteiro/AquaSense/Documentacao/3aEntrega/Ficheiros/Prototipo/imagem_016.jpeg

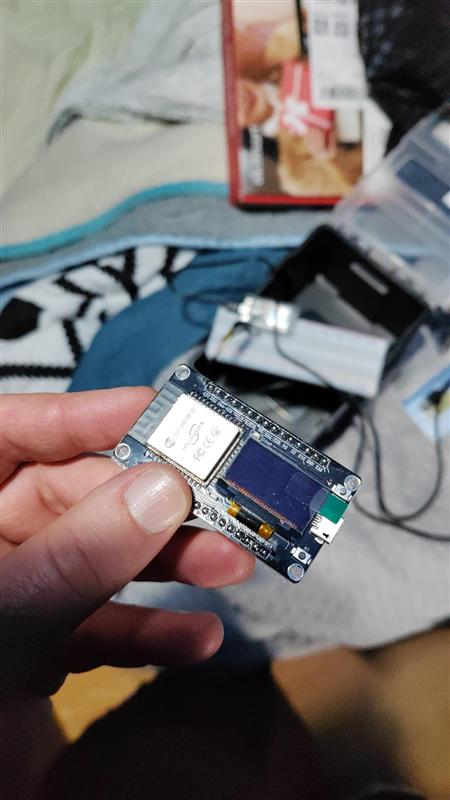
Documentacao/3aEntrega/Ficheiros/Prototipo/imagem_016.jpeg
