RuiOuteiro/AquaSense/Documentacao/3aEntrega/Ficheiros/Prototipo/imagem_017.jpeg

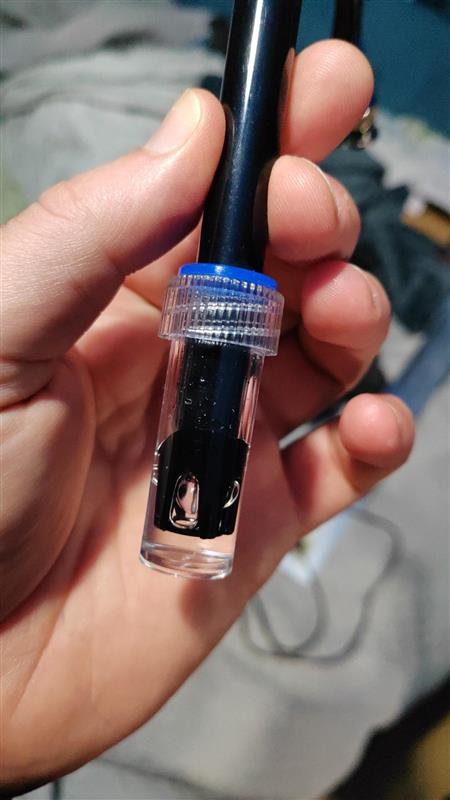
Documentacao/3aEntrega/Ficheiros/Prototipo/imagem_017.jpeg
