RuiOuteiro/AquaSense/Documentacao/3aEntrega/Ficheiros/Prototipo/imagem_018.jpeg

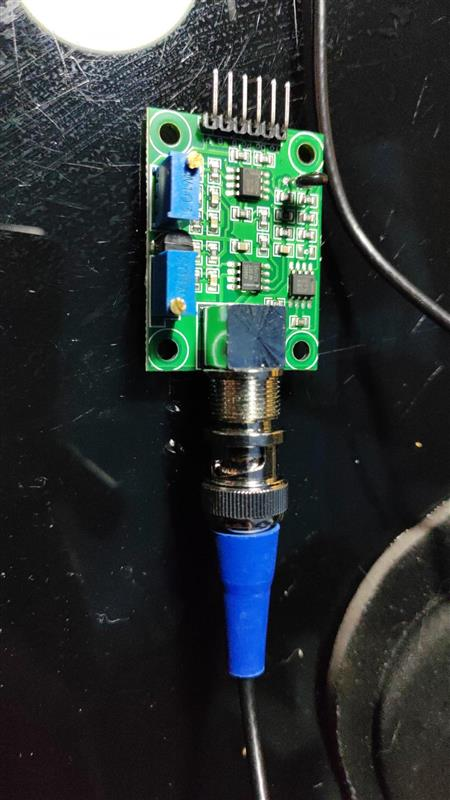
Documentacao/3aEntrega/Ficheiros/Prototipo/imagem_018.jpeg
