RuiOuteiro/AquaSense/Documentacao/3aEntrega/Ficheiros/Prototipo/imagem_019.jpeg

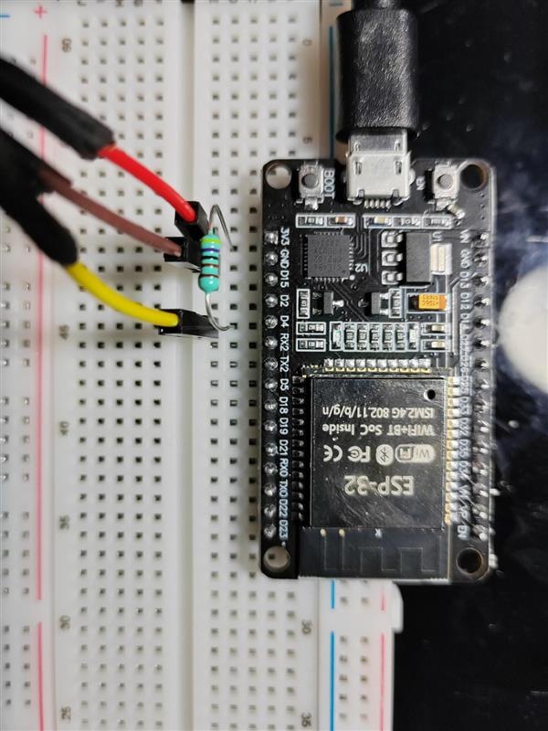
Documentacao/3aEntrega/Ficheiros/Prototipo/imagem_019.jpeg
