RuiOuteiro/AquaSense/Documentacao/3aEntrega/Ficheiros/Prototipo/imagem_020.jpeg

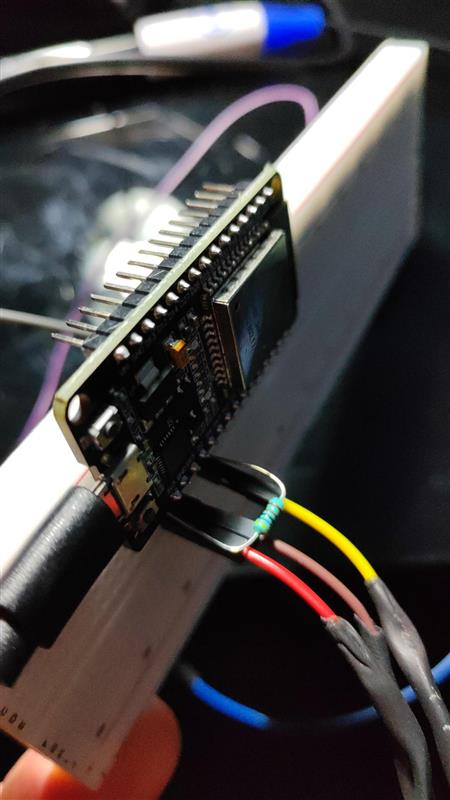
Documentacao/3aEntrega/Ficheiros/Prototipo/imagem_020.jpeg
