RuiOuteiro/AquaSense/Documentacao/3aEntrega/Ficheiros/Prototipo/imagem_021.jpeg

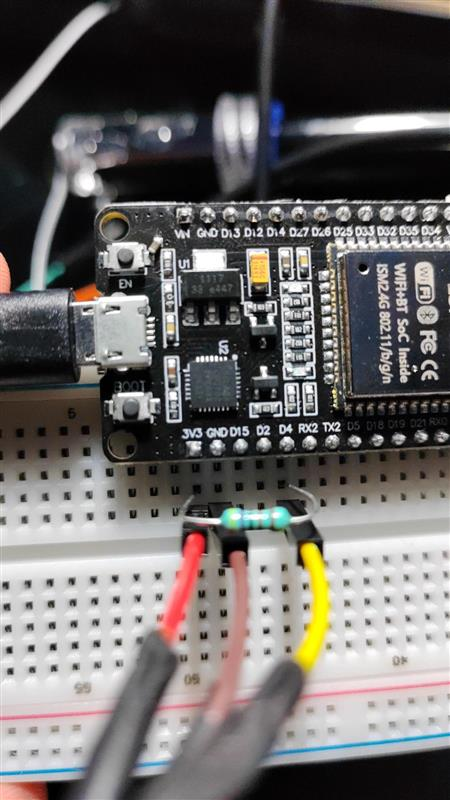
Documentacao/3aEntrega/Ficheiros/Prototipo/imagem_021.jpeg
