RuiOuteiro/AquaSense/Documentacao/3aEntrega/Ficheiros/Prototipo/imagem_022.jpeg

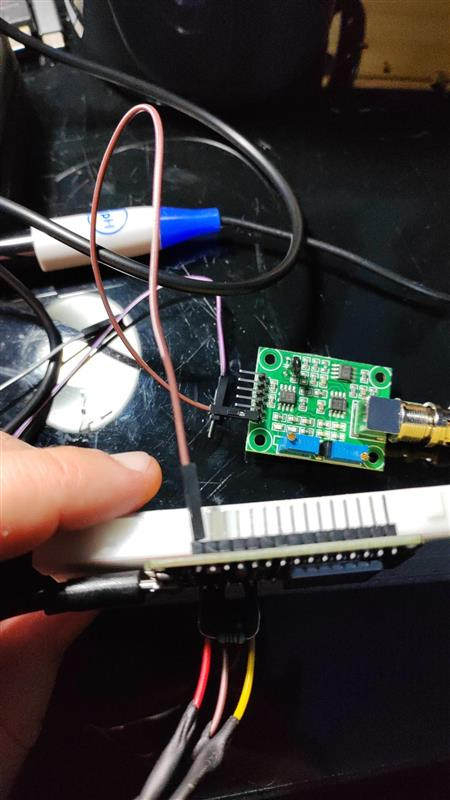
Documentacao/3aEntrega/Ficheiros/Prototipo/imagem_022.jpeg
