RuiOuteiro/AquaSense/Documentacao/3aEntrega/Ficheiros/Prototipo/imagem_023.jpeg

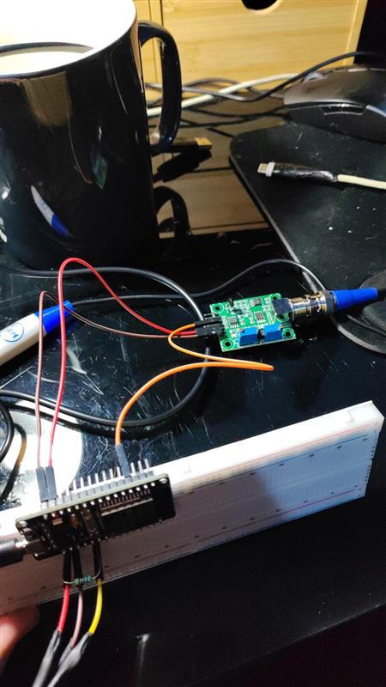
Documentacao/3aEntrega/Ficheiros/Prototipo/imagem_023.jpeg
