RuiOuteiro/AquaSense/Documentacao/3aEntrega/Ficheiros/Prototipo/imagem_024.jpeg

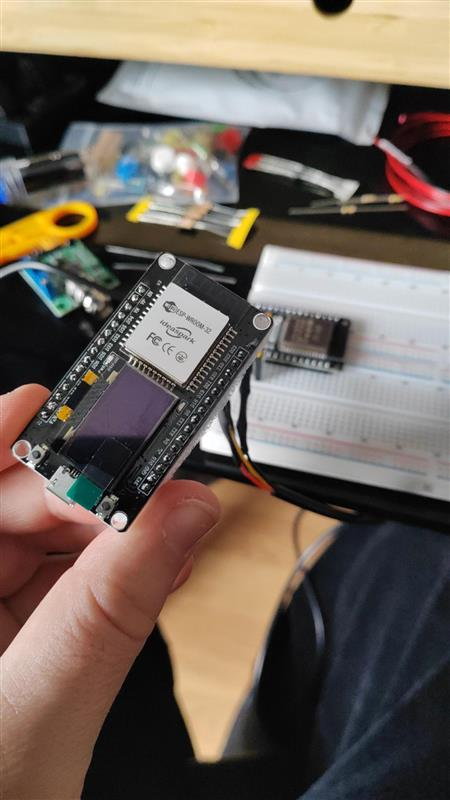
Documentacao/3aEntrega/Ficheiros/Prototipo/imagem_024.jpeg
