RuiOuteiro/AquaSense/Documentacao/3aEntrega/Ficheiros/Prototipo/imagem_025.jpeg

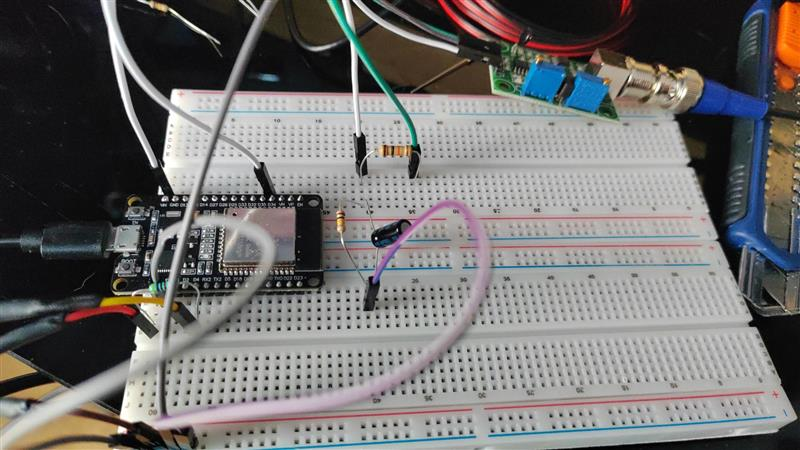
Documentacao/3aEntrega/Ficheiros/Prototipo/imagem_025.jpeg
