RuiOuteiro/AquaSense/Documentacao/3aEntrega/Ficheiros/Prototipo/imagem_026.jpeg

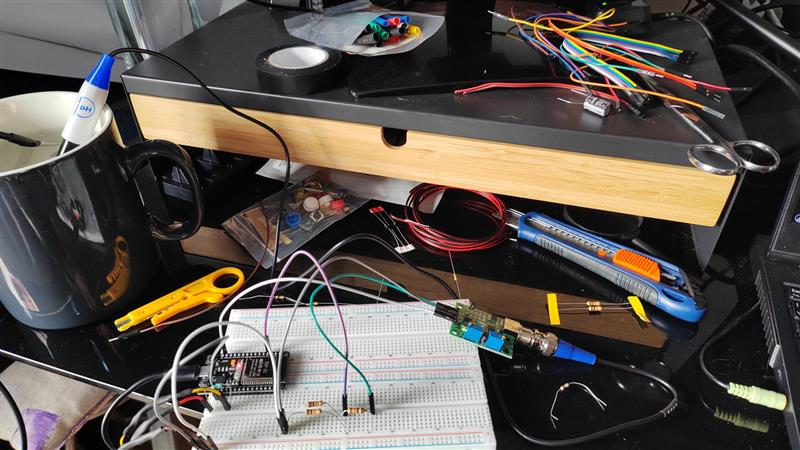
Documentacao/3aEntrega/Ficheiros/Prototipo/imagem_026.jpeg
