RuiOuteiro/AquaSense/Documentacao/3aEntrega/Ficheiros/Prototipo/imagem_027.jpeg

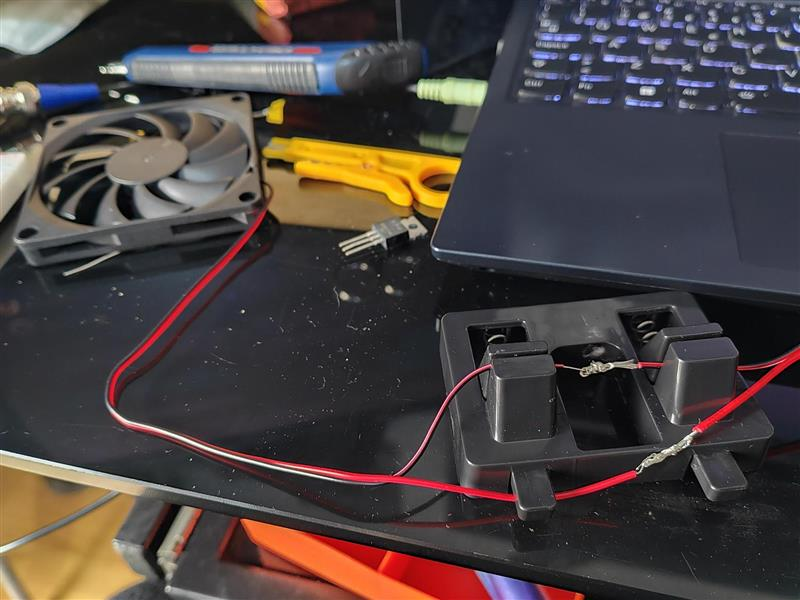
Documentacao/3aEntrega/Ficheiros/Prototipo/imagem_027.jpeg
