RuiOuteiro/AquaSense/Documentacao/3aEntrega/Ficheiros/Prototipo/imagem_028.jpeg

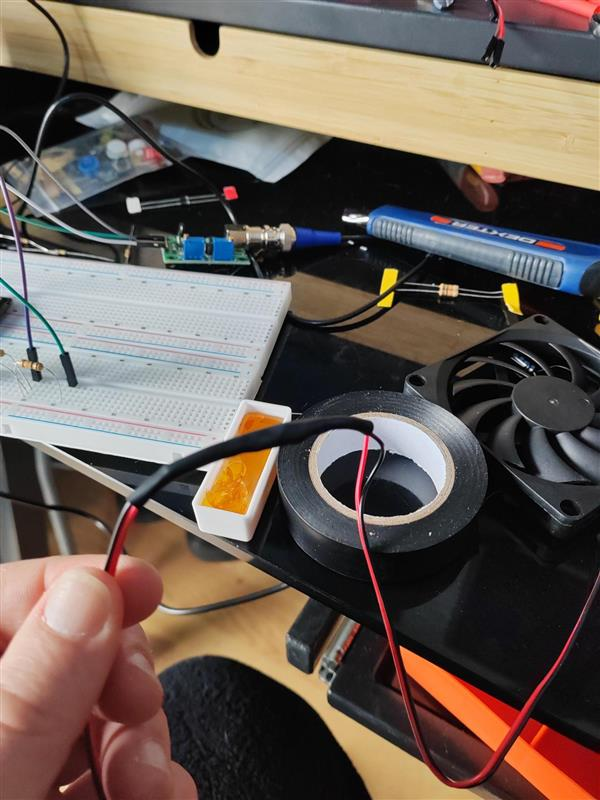
Documentacao/3aEntrega/Ficheiros/Prototipo/imagem_028.jpeg
