RuiOuteiro/AquaSense/Documentacao/3aEntrega/Ficheiros/Prototipo/imagem_029.jpeg

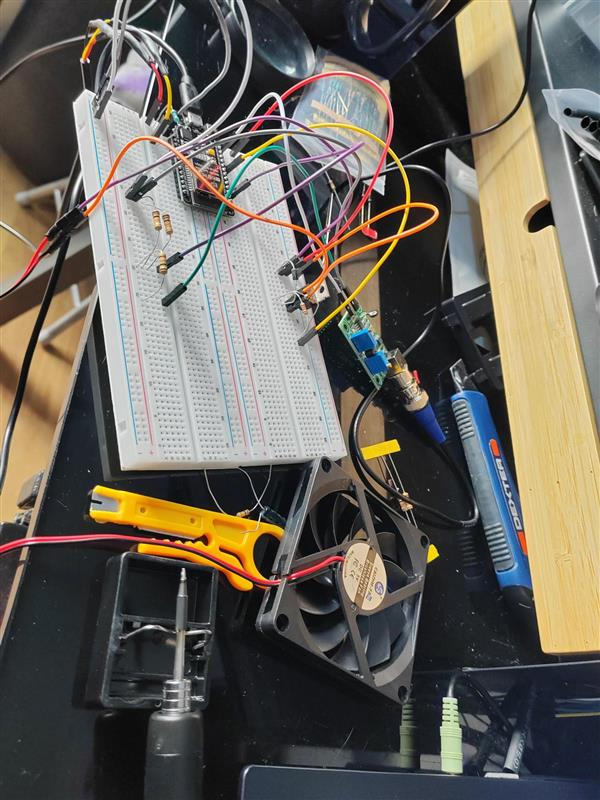
Documentacao/3aEntrega/Ficheiros/Prototipo/imagem_029.jpeg
