RuiOuteiro/AquaSense/Documentacao/3aEntrega/Ficheiros/Prototipo/imagem_041.jpeg

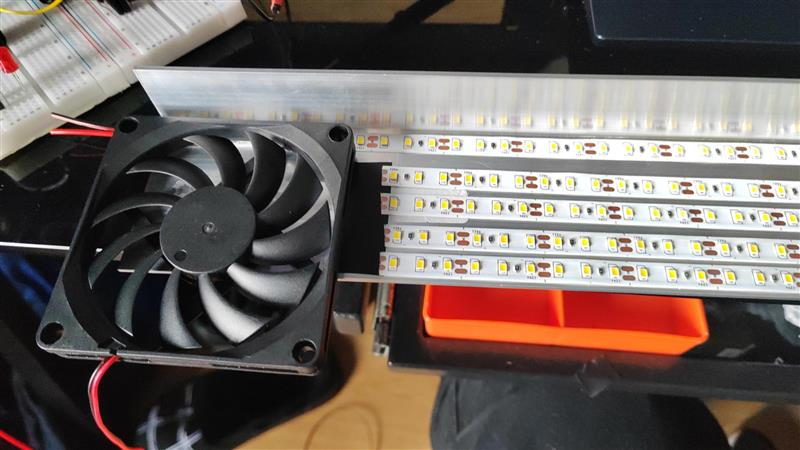
Documentacao/3aEntrega/Ficheiros/Prototipo/imagem_041.jpeg
