RuiOuteiro/AquaSense/Documentacao/3aEntrega/Ficheiros/Prototipo/imagem_043.jpeg

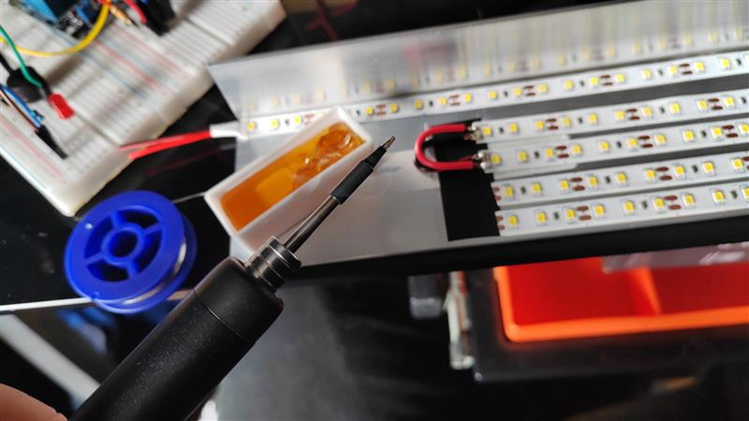
Documentacao/3aEntrega/Ficheiros/Prototipo/imagem_043.jpeg
