RuiOuteiro/AquaSense/Documentacao/3aEntrega/Ficheiros/Prototipo/imagem_044.jpeg

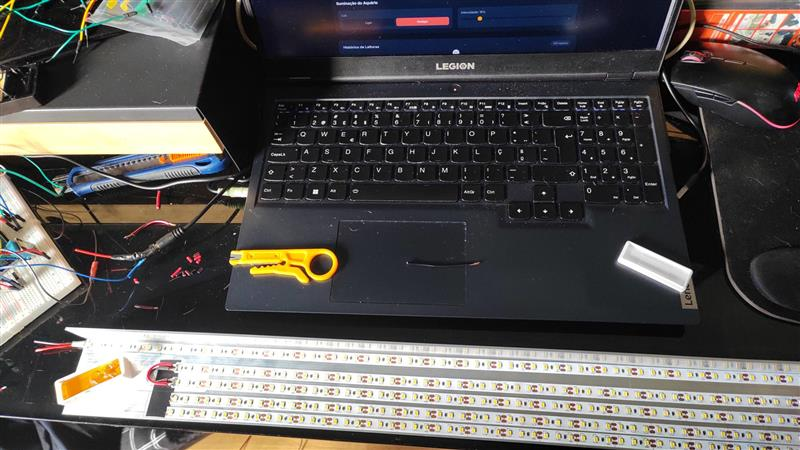
Documentacao/3aEntrega/Ficheiros/Prototipo/imagem_044.jpeg
