RuiOuteiro/AquaSense/Documentacao/3aEntrega/Ficheiros/Prototipo/imagem_045.jpeg

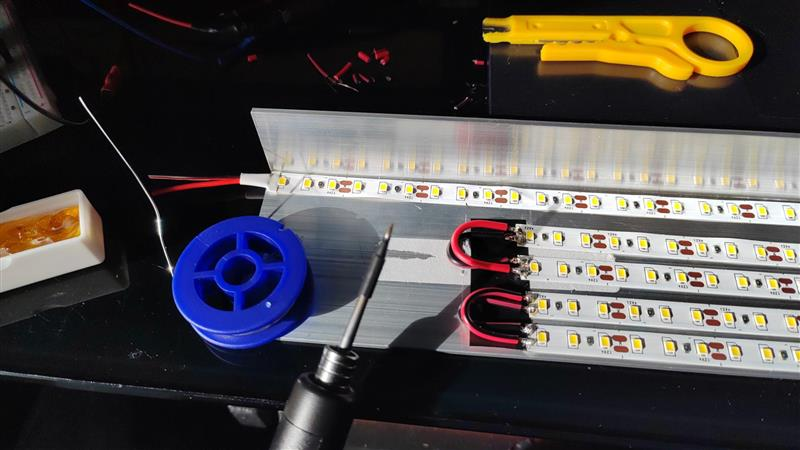
Documentacao/3aEntrega/Ficheiros/Prototipo/imagem_045.jpeg
