RuiOuteiro/AquaSense/Documentacao/3aEntrega/Ficheiros/Prototipo/imagem_046.jpeg

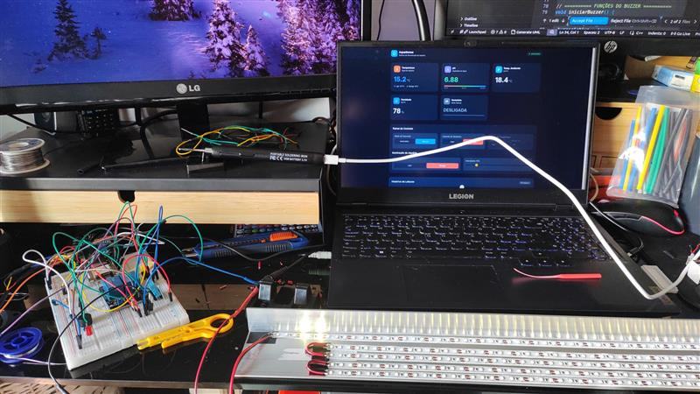
Documentacao/3aEntrega/Ficheiros/Prototipo/imagem_046.jpeg
