RuiOuteiro/AquaSense/Documentacao/3aEntrega/Ficheiros/Prototipo/imagem_047.jpeg

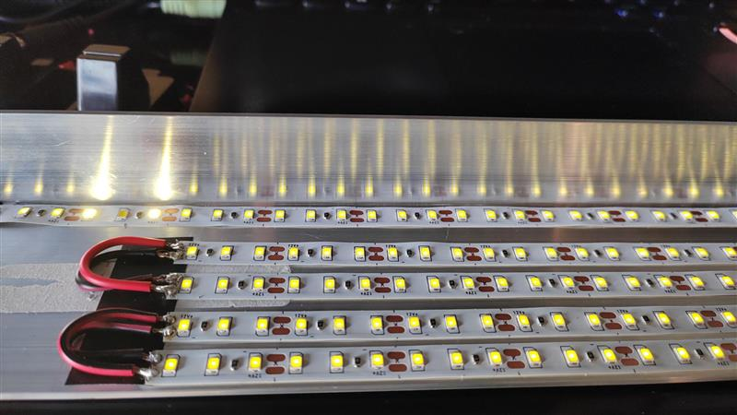
Documentacao/3aEntrega/Ficheiros/Prototipo/imagem_047.jpeg
