RuiOuteiro/AquaSense/Documentacao/3aEntrega/Ficheiros/Prototipo/imagem_048.jpeg

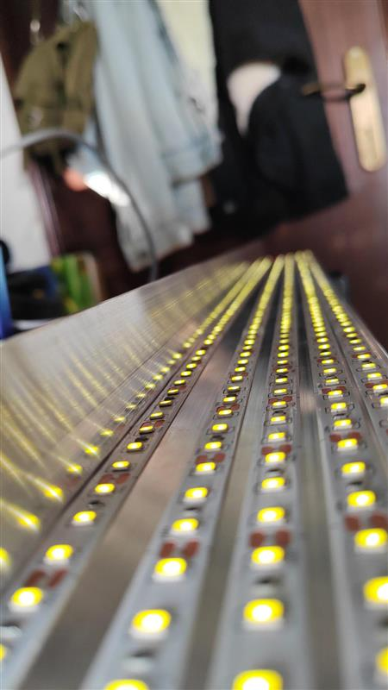
Documentacao/3aEntrega/Ficheiros/Prototipo/imagem_048.jpeg
