RuiOuteiro/AquaSense/Documentacao/3aEntrega/Ficheiros/Prototipo/imagem_049.jpeg

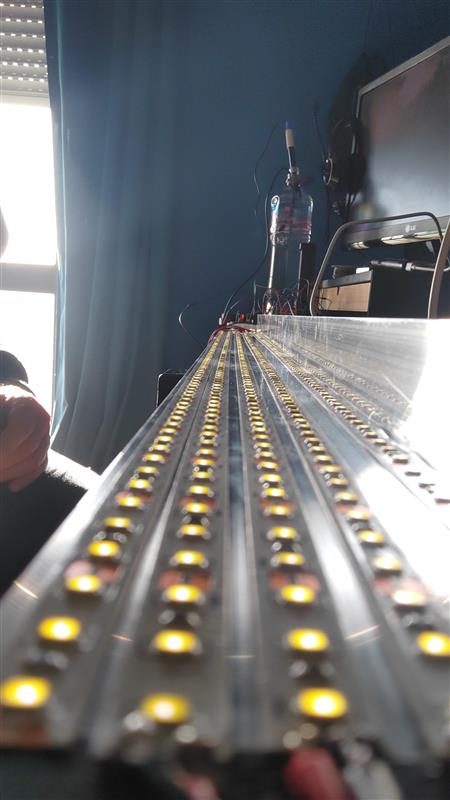
Documentacao/3aEntrega/Ficheiros/Prototipo/imagem_049.jpeg
