RuiOuteiro/AquaSense/Documentacao/3aEntrega/Ficheiros/Prototipo/imagem_050.jpeg

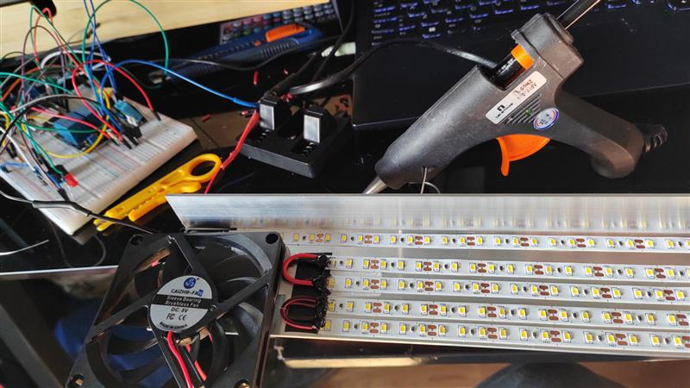
Documentacao/3aEntrega/Ficheiros/Prototipo/imagem_050.jpeg
