RuiOuteiro/AquaSense/Documentacao/3aEntrega/Ficheiros/Prototipo/imagem_051.jpeg

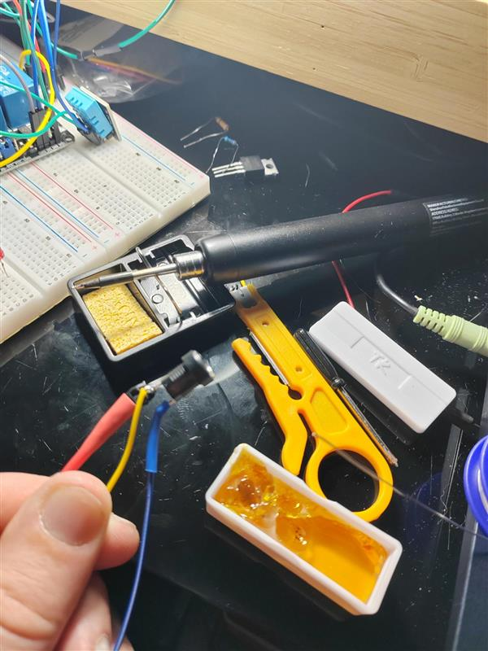
Documentacao/3aEntrega/Ficheiros/Prototipo/imagem_051.jpeg
