RuiOuteiro/AquaSense/Documentacao/3aEntrega/Ficheiros/Prototipo/imagem_052.jpeg

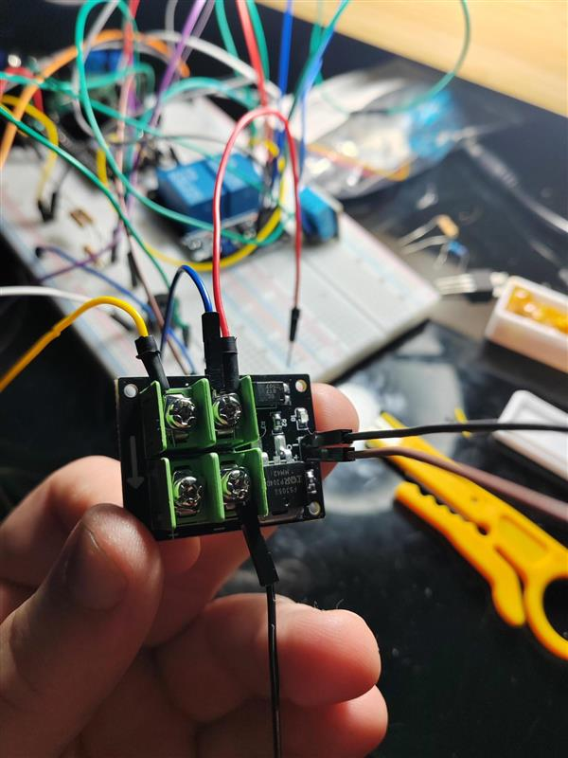
Documentacao/3aEntrega/Ficheiros/Prototipo/imagem_052.jpeg
