RuiOuteiro/AquaSense/Documentacao/3aEntrega/Ficheiros/Prototipo/imagem_053.jpeg

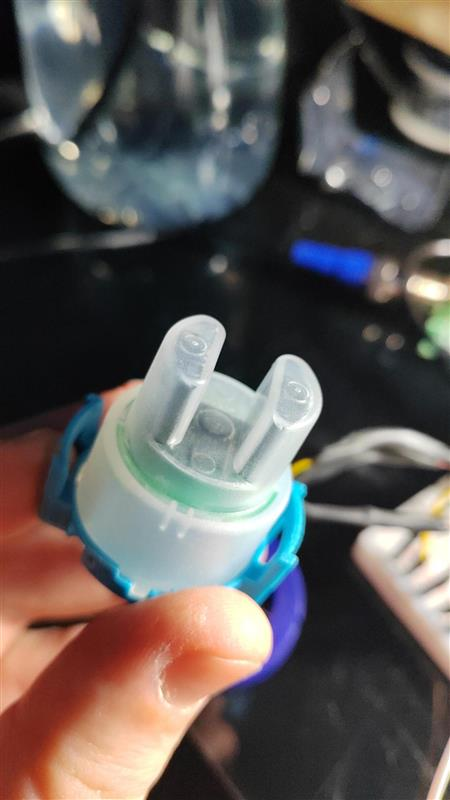
Documentacao/3aEntrega/Ficheiros/Prototipo/imagem_053.jpeg
