RuiOuteiro/AquaSense/Documentacao/3aEntrega/Ficheiros/Prototipo/imagem_054.jpeg

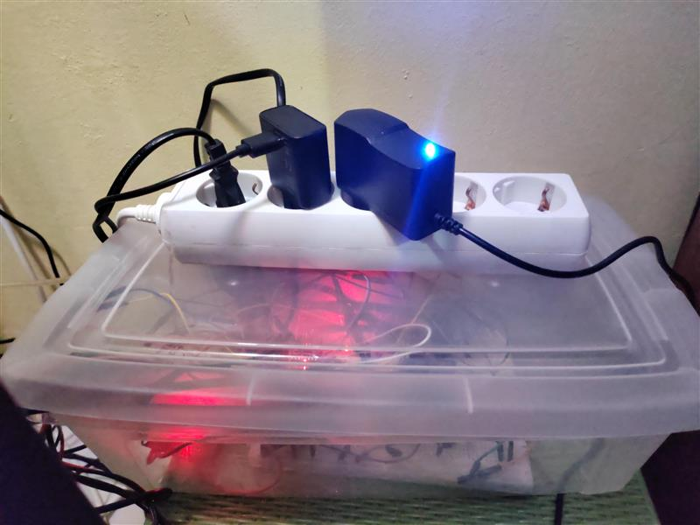
Documentacao/3aEntrega/Ficheiros/Prototipo/imagem_054.jpeg
