RuiOuteiro/AquaSense/Documentacao/3aEntrega/Ficheiros/Prototipo/imagem_055.jpeg

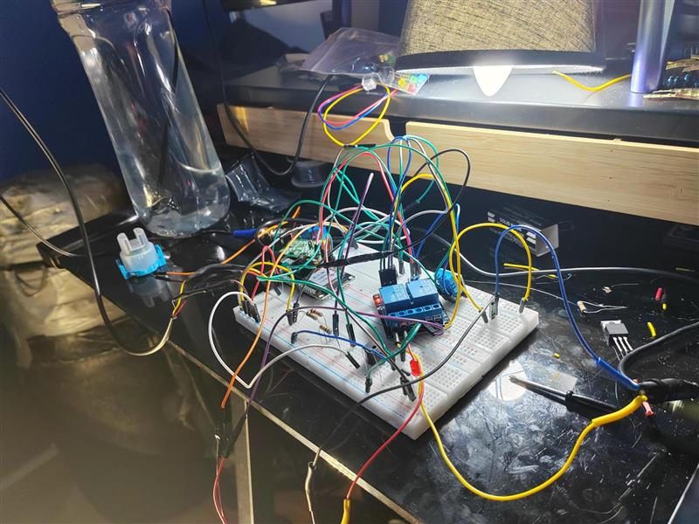
Documentacao/3aEntrega/Ficheiros/Prototipo/imagem_055.jpeg
