RuiOuteiro/AquaSense/Documentacao/3aEntrega/Ficheiros/Prototipo/imagem_056.jpeg

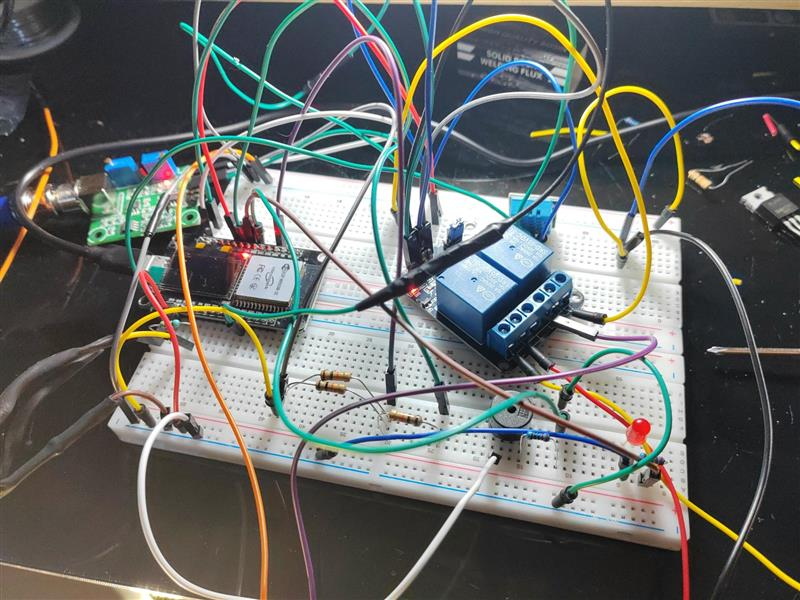
Documentacao/3aEntrega/Ficheiros/Prototipo/imagem_056.jpeg
