RuiOuteiro/AquaSense/Documentacao/3aEntrega/Ficheiros/Prototipo/imagem_057.jpeg

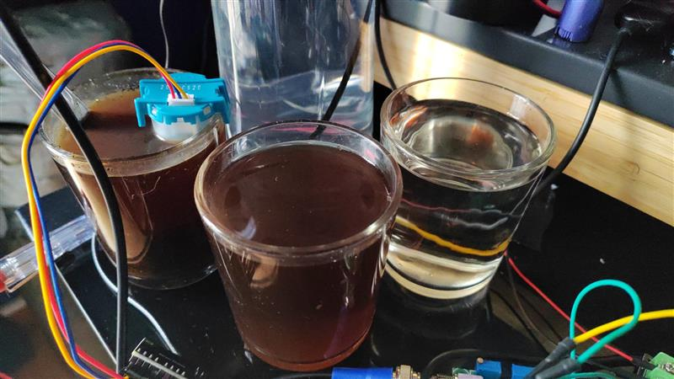
Documentacao/3aEntrega/Ficheiros/Prototipo/imagem_057.jpeg
