RuiOuteiro/AquaSense/Documentacao/3aEntrega/Ficheiros/Prototipo/imagem_058.jpeg

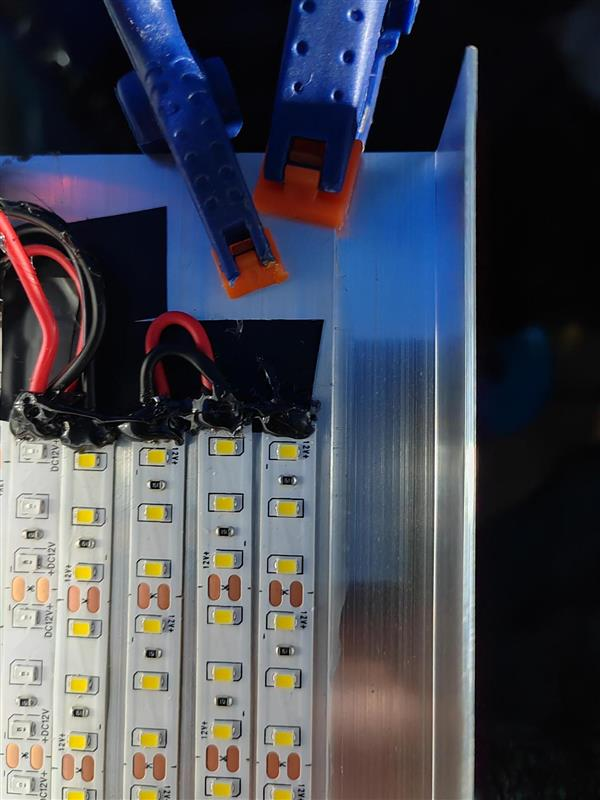
Documentacao/3aEntrega/Ficheiros/Prototipo/imagem_058.jpeg
