RuiOuteiro/AquaSense/Documentacao/3aEntrega/Ficheiros/Prototipo/imagem_059.jpeg

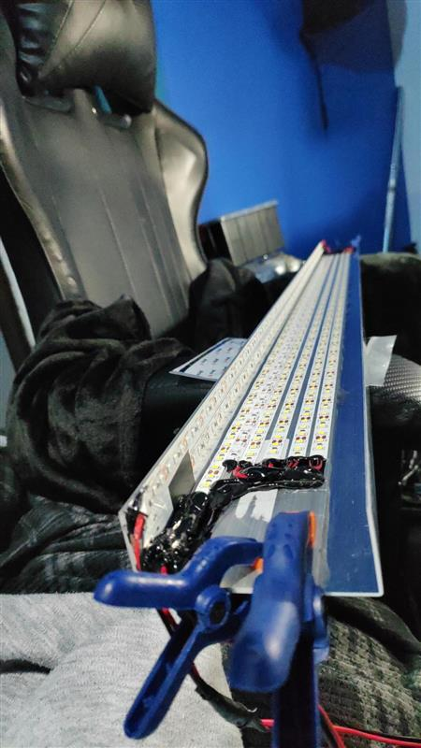
Documentacao/3aEntrega/Ficheiros/Prototipo/imagem_059.jpeg
