RuiOuteiro/AquaSense/Documentacao/3aEntrega/Ficheiros/Prototipo/imagem_060.jpeg

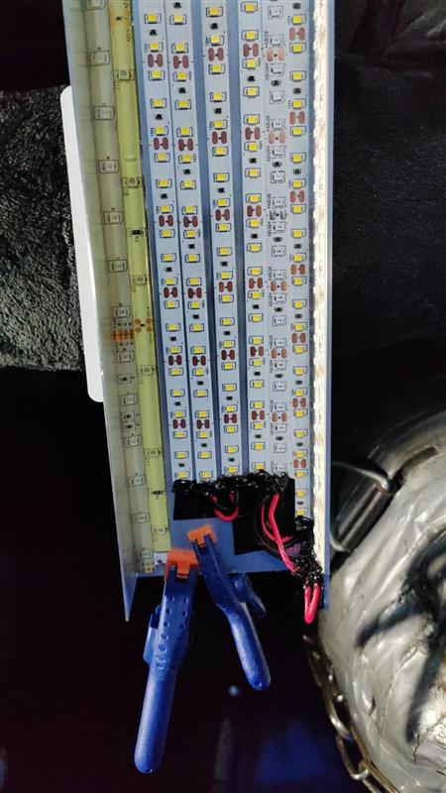
Documentacao/3aEntrega/Ficheiros/Prototipo/imagem_060.jpeg
