RuiOuteiro/AquaSense/Documentacao/3aEntrega/Ficheiros/Prototipo/imagem_061.jpeg

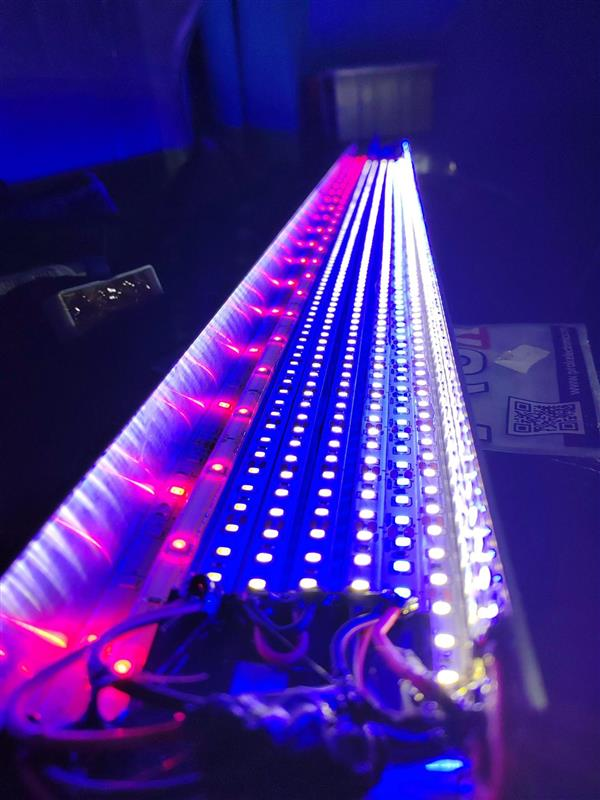
Documentacao/3aEntrega/Ficheiros/Prototipo/imagem_061.jpeg
