RuiOuteiro/AquaSense/Documentacao/3aEntrega/Ficheiros/Prototipo/imagem_062.jpeg

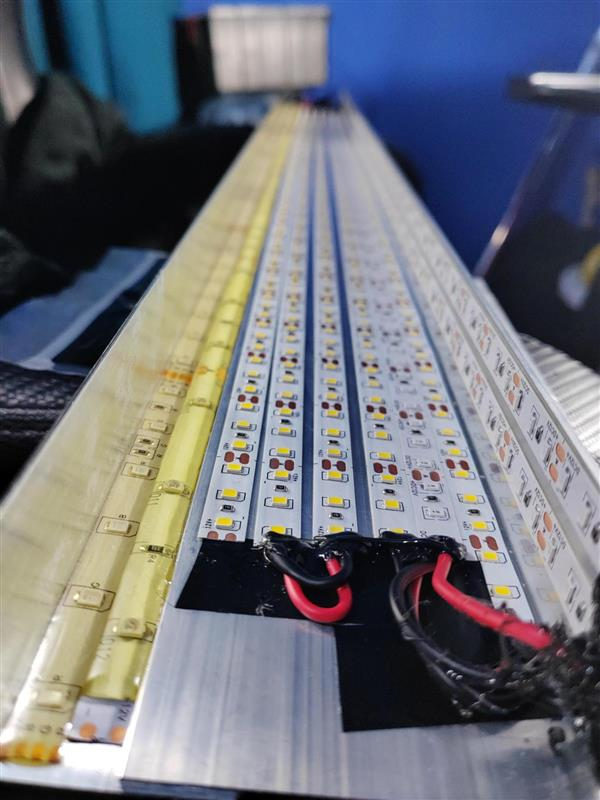
Documentacao/3aEntrega/Ficheiros/Prototipo/imagem_062.jpeg
