RuiOuteiro/AquaSense/Documentacao/3aEntrega/Ficheiros/Prototipo/imagem_063.jpeg

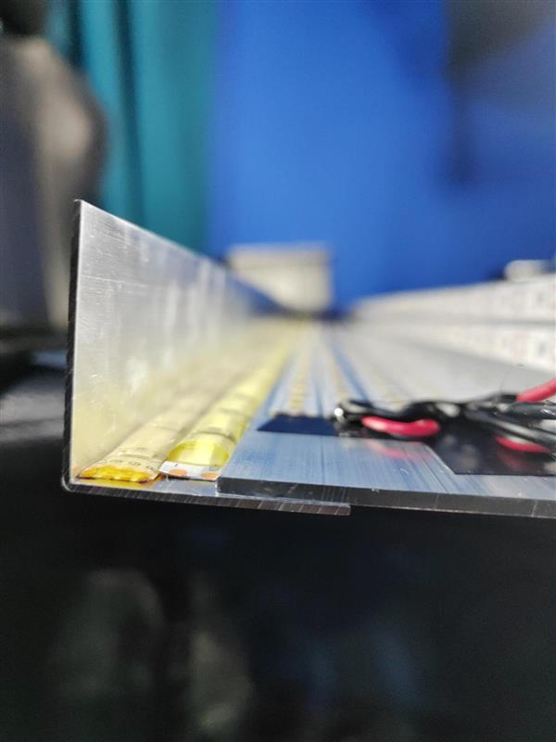
Documentacao/3aEntrega/Ficheiros/Prototipo/imagem_063.jpeg
