RuiOuteiro/AquaSense/Documentacao/3aEntrega/Ficheiros/Prototipo/imagem_064.jpeg

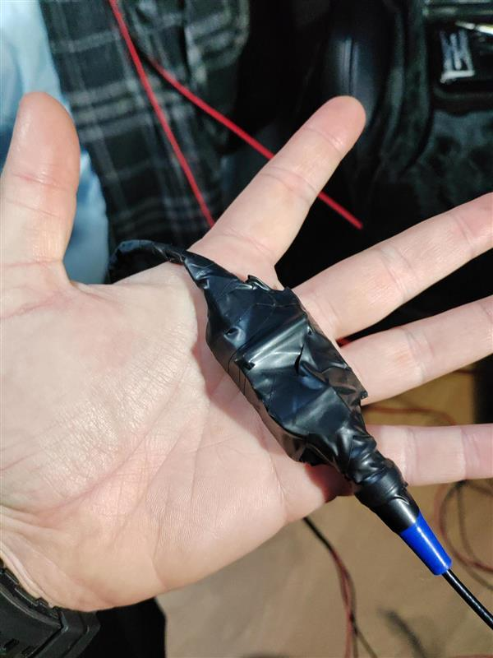
Documentacao/3aEntrega/Ficheiros/Prototipo/imagem_064.jpeg
