RuiOuteiro/AquaSense/Documentacao/3aEntrega/Ficheiros/Prototipo/imagem_065.jpeg

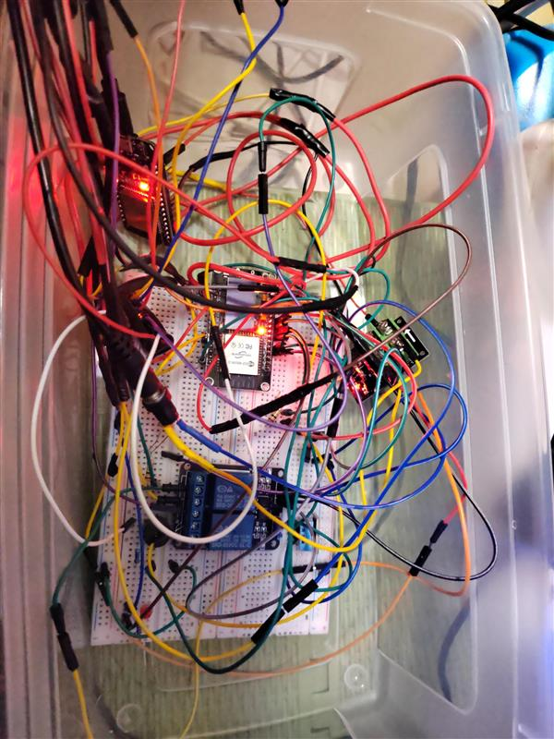
Documentacao/3aEntrega/Ficheiros/Prototipo/imagem_065.jpeg
