RuiOuteiro/AquaSense/Documentacao/3aEntrega/Ficheiros/Prototipo/imagem_066.jpeg

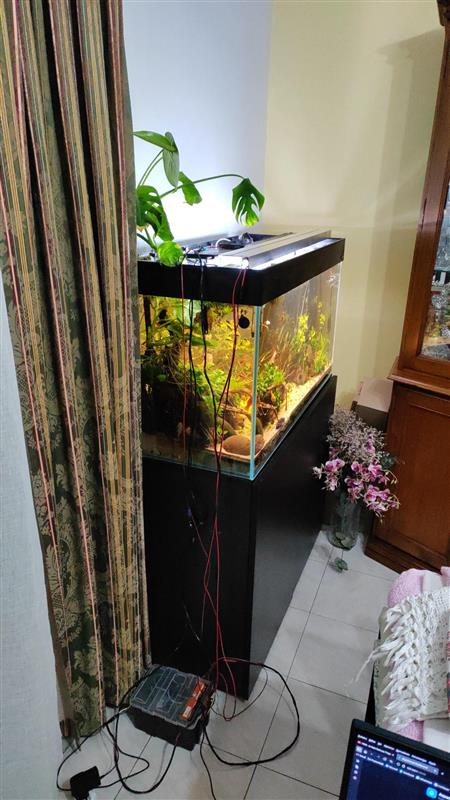
Documentacao/3aEntrega/Ficheiros/Prototipo/imagem_066.jpeg
