RuiOuteiro/AquaSense/Documentacao/3aEntrega/Ficheiros/Prototipo/imagem_067.jpeg

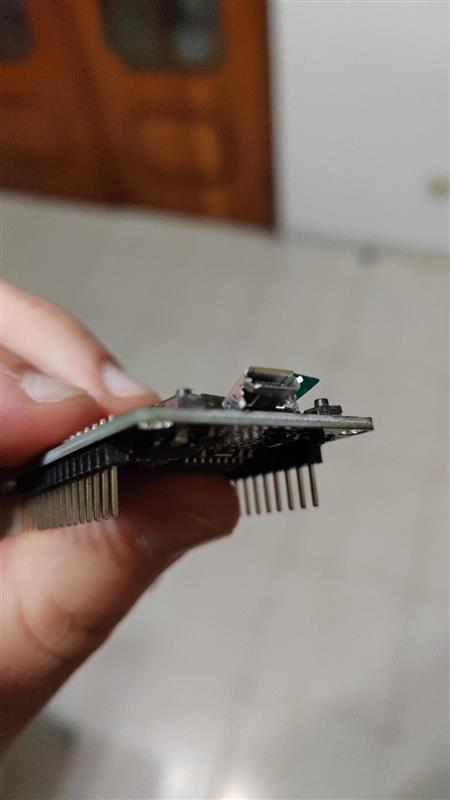
Documentacao/3aEntrega/Ficheiros/Prototipo/imagem_067.jpeg
