RuiOuteiro/AquaSense/Documentacao/3aEntrega/Ficheiros/Prototipo/imagem_068.jpeg

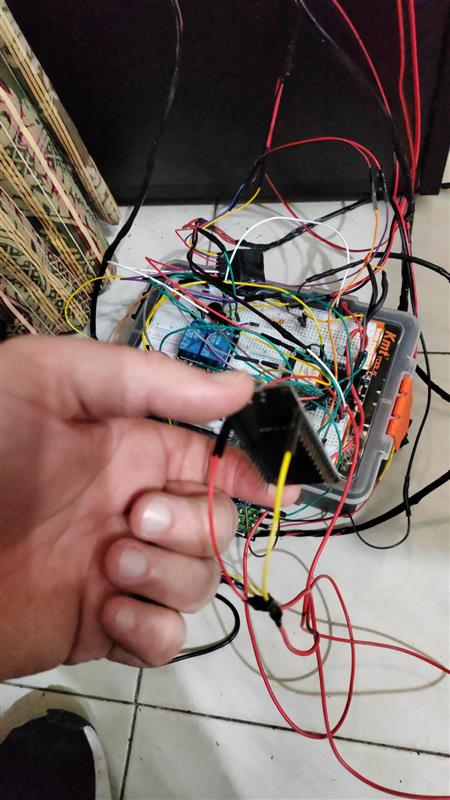
Documentacao/3aEntrega/Ficheiros/Prototipo/imagem_068.jpeg
