RuiOuteiro/AquaSense/Documentacao/3aEntrega/Ficheiros/Prototipo/imagem_069.jpeg

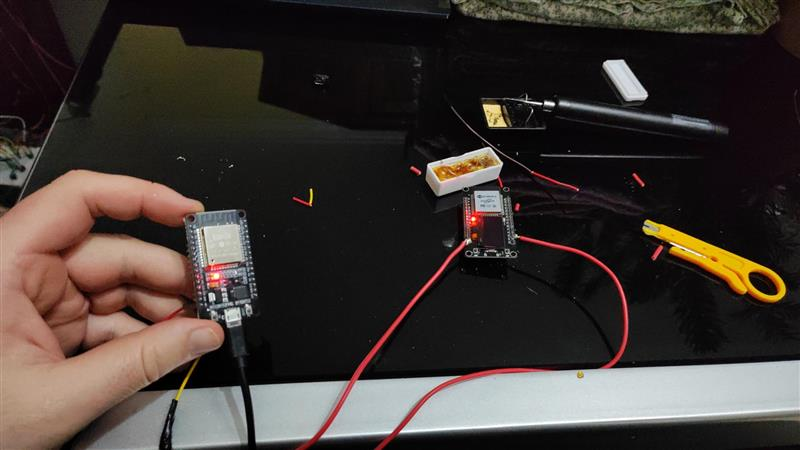
Documentacao/3aEntrega/Ficheiros/Prototipo/imagem_069.jpeg
