RuiOuteiro/AquaSense/Documentacao/3aEntrega/Ficheiros/Prototipo/imagem_070.jpeg

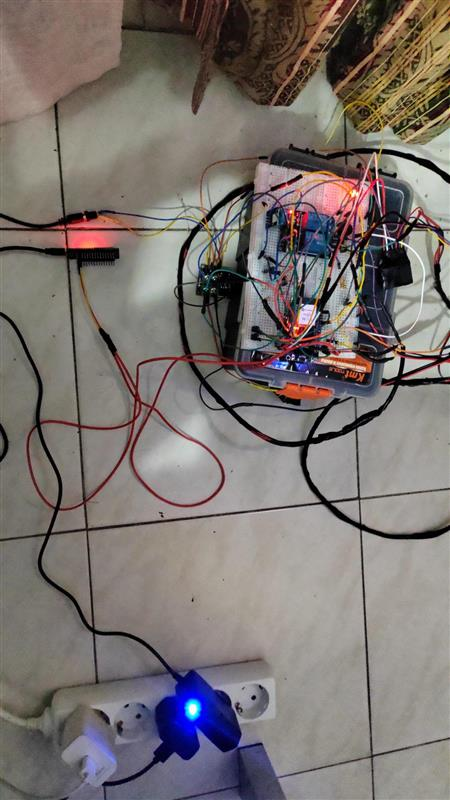
Documentacao/3aEntrega/Ficheiros/Prototipo/imagem_070.jpeg
