RuiOuteiro/AquaSense/Documentacao/3aEntrega/Ficheiros/Prototipo/imagem_071.jpeg

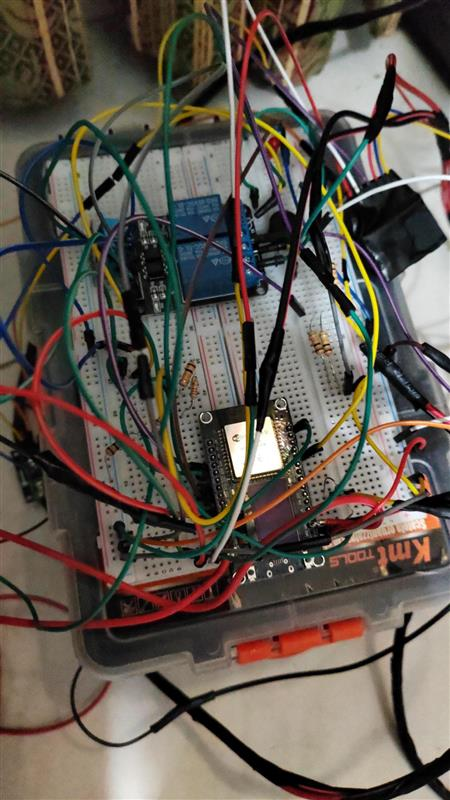
Documentacao/3aEntrega/Ficheiros/Prototipo/imagem_071.jpeg
