RuiOuteiro/AquaSense/Documentacao/3aEntrega/Ficheiros/Prototipo/imagem_072.jpeg

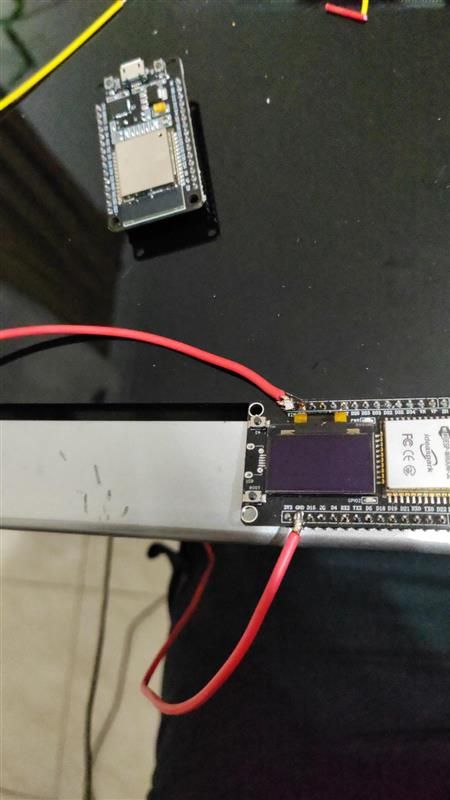
Documentacao/3aEntrega/Ficheiros/Prototipo/imagem_072.jpeg
