RuiOuteiro/AquaSense/Documentacao/3aEntrega/Ficheiros/Prototipo/imagem_073.jpeg

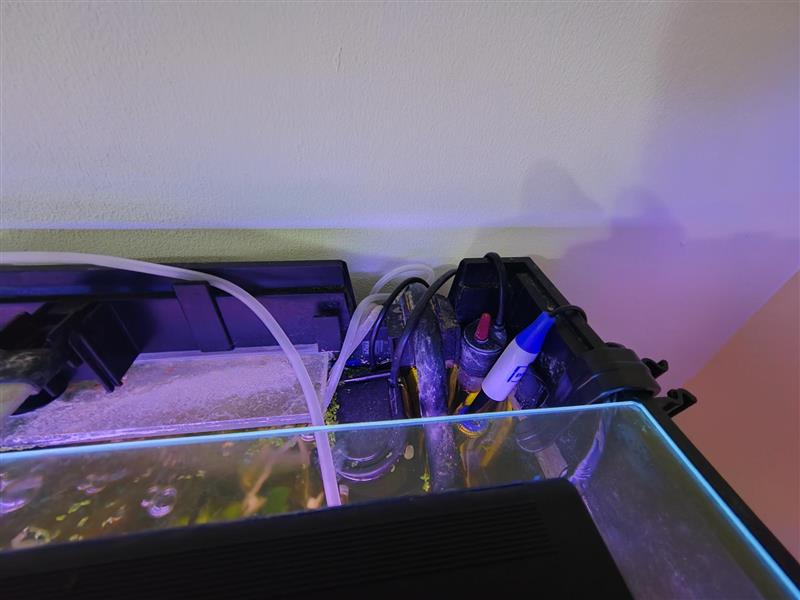
Documentacao/3aEntrega/Ficheiros/Prototipo/imagem_073.jpeg
