RuiOuteiro/AquaSense/Documentacao/3aEntrega/Ficheiros/Prototipo/imagem_074.jpeg

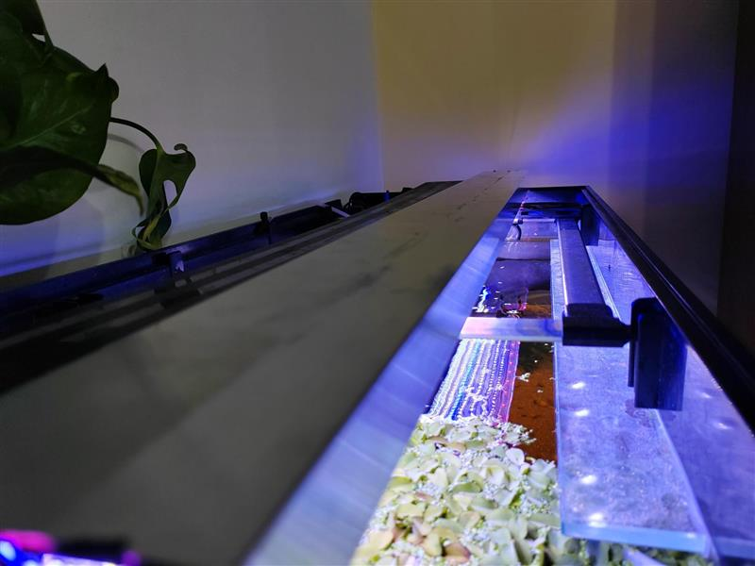
Documentacao/3aEntrega/Ficheiros/Prototipo/imagem_074.jpeg
