RuiOuteiro/AquaSense/Documentacao/3aEntrega/Ficheiros/Prototipo/imagem_075.jpeg

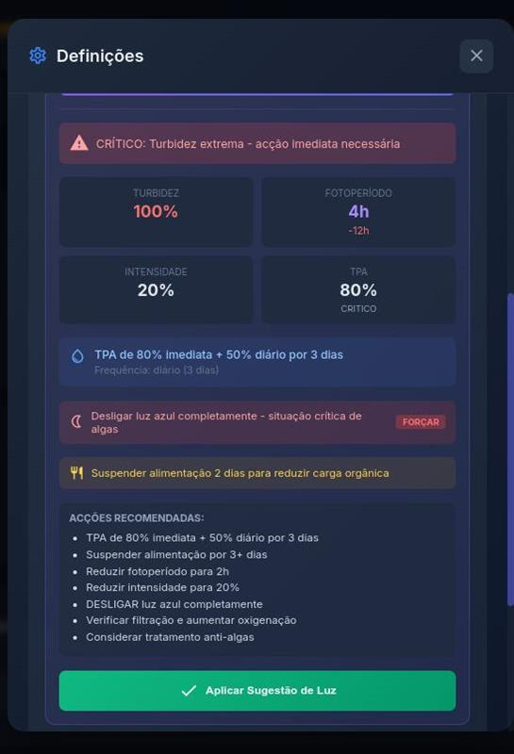
Documentacao/3aEntrega/Ficheiros/Prototipo/imagem_075.jpeg
