RuiOuteiro/AquaSense/Documentacao/3aEntrega/Ficheiros/Prototipo/imagem_076.jpeg

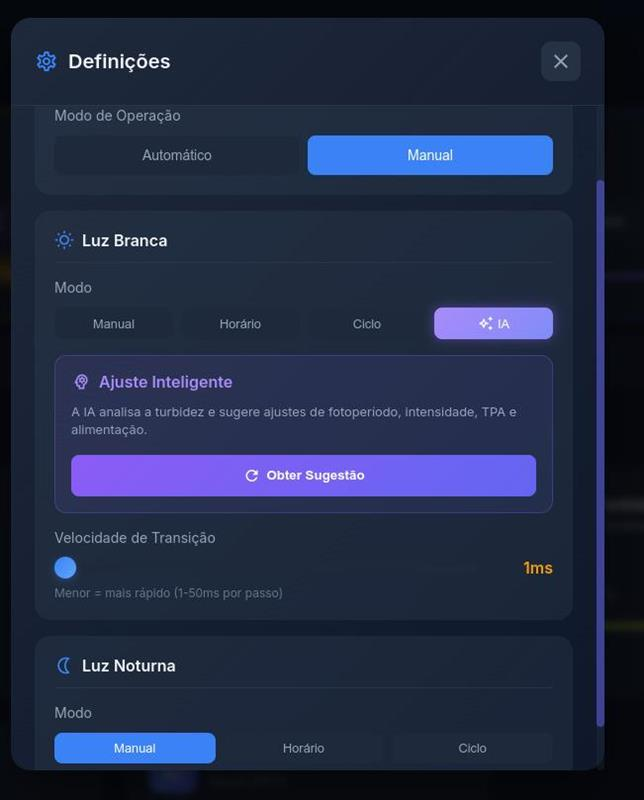
Documentacao/3aEntrega/Ficheiros/Prototipo/imagem_076.jpeg
