RuiOuteiro/AquaSense/Documentacao/3aEntrega/Ficheiros/Prototipo/imagem_077.jpeg

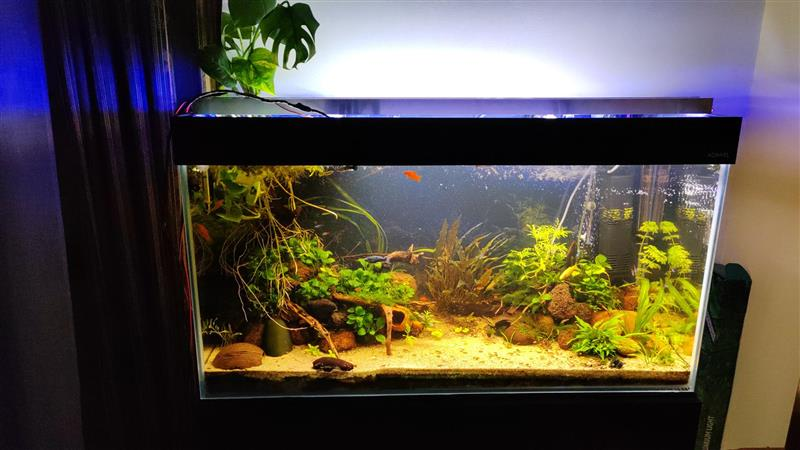
Documentacao/3aEntrega/Ficheiros/Prototipo/imagem_077.jpeg
