RuiOuteiro/AquaSense/Documentacao/3aEntrega/Ficheiros/Prototipo/imagem_078.jpeg

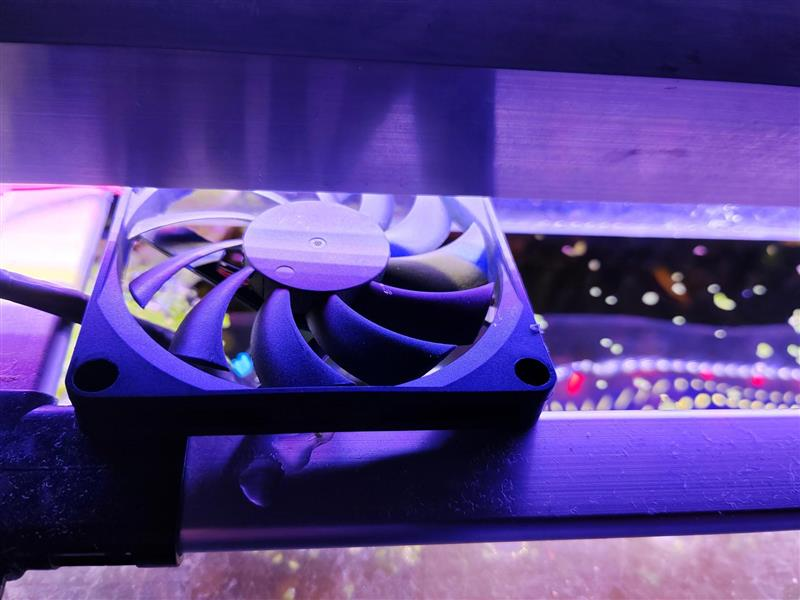
Documentacao/3aEntrega/Ficheiros/Prototipo/imagem_078.jpeg
