RuiOuteiro/AquaSense/(commit log)

2026-01-22 AquaSense - Sistema de monitorização de aquário
2026-01-23 Ajuste de pastas
2026-01-27 Delete esp32-dashboard/ai directory
    Substituir
2026-01-27 Renomear a pasta
    [Planeamento_PBL.xlsx]
2026-01-31 adicionada classe para brilho luz
2026-02-01 Ajustar ficheiro para entrega final
2026-02-02 Criacao de pasta e inicio de relatório finais
2026-02-02 Extensão para gerar TOC
2026-02-02 Extensão para TOC até nivel 2
2026-02-02 Update and rename README.md to esp32-dashboard/README.md
2026-02-04 Atualização de documentação
2026-02-04 Adicionar imagem do circuito
2026-02-04 Remoção de notebooks não necessários
2026-02-04 feat/sistema de autenticação e alertas
2026-02-05 Refactorização de componentes
2026-02-06 Ajuste para configurar deviceid
2026-02-06 Adicionei links para os relatórios de IA
